BernardoPironio/Polarimetro/Informe/temp/Informe.pdf

Construcción de un polarímetro óptico dinámico

Grupo 13

Barros Martina, Pironio Bernardo

barrosmartina.bm@gmail.com, bpironio@gmail.com

Laboratorio de iones y atomos frios, 1

er cuatrimestre 2026
Departamento de Física, FCEyN, UBA

20 de julio de 2026

Resumen

Se presenta el diseño y construcción de un polarímetro óptico dinámico destinado a la caracterización del estado de polarización de un haz de luz mediante la reconstrucción de sus parámetros de Stokes. El sistema óptico está compuesto por una lámina de cuarto de onda en rotación continua y un polarizador lineal, mientras que la intensidad transmitida se registra mediante un fotodiodo. La rotación de la lámina se implementa utilizando un motor brushless, cuya posición angular se sincroniza mediante un sensor magnético. El sistema electrónico incorpora un circuito el cual posee un potenciómetro digital que permite optimizar la adquisición evitando la saturación del detector. Asimismo, se desarrolla un software de adquisición y análisis capaz de registrar los datos en tiempo real, realizar la calibración del instrumento y reconstruir el estado de polarización del haz incidente. Si bien la implementación final del polarímetro no se completa durante este trabajo, se verifica el correcto funcionamiento de cada uno de los subsistemas desarrollados, aunque a aún son necesarias revisiones y ajustes en la calibración y en el montaje óptico para alcanzar una integración completa del sistema.

### 1. Introducción

En la física, particularmente la óptica cuántica, el estado de polarización de la luz es un recurso fundamental. Para poder medir y tener control sobre la polarización es útil contar con un polarímetro dinámico. Este instrumento permite medir el estado de polarización de la luz en tiempo real y de forma automatizada.
Existen extensos ejemplos de la utilidad de contar con un polarímetro, uno de estos es la codificación de información en la polarización de los fotones, ya que es un grado de libertad del cual se tiene un control robusto. Otro ejemplo aparece en la medición de resonancias oscuras de los iones, donde un estado de polarización inestable provoca que los valles de la señal de fluorescencia no sean tan distinguibles como se requiere para la medición de resonancia [1].
Una de las formas de describir el estado de polarización de la luz es a partir de los parámetros de Stokes [2]. Estos cuatro parámetros S0, S1, S2 y S3 nos indican la intensidad de la luz, la diferencia de intensidades entre luz polarizada horizontal y vertical, la diferencia de intensidades entre luz polarizada a 45◦ y −45◦ y la diferencia de intensidades entre luz polarizada circularmente a derecha e izquierda, respectivamente. Estos parámetros luego definen al vector de Stokes,

S⃗ =

s1
s2
s3
- ,

donde si = Si/S0. Este vector permite representar el estado de polarización de la luz en la esfera de Poincaré, tal que los polos representan la polarización circular y el ecuador representa la polarización lineal. Además, es posible definir el grado de polarización como,

DOP =

q
s

2
1 + s

2
2 + s

2/3.

Entre las múltiples posibilidades para la construcción del polarímetro [3], un diseño común consiste en una lámina de onda seguida de un polarizador lineal. Para describir matemáticamente estos elementos ópticos, y por lo tanto el sistema, se utilizan las matrices de Müller.
Si se considera una polarización incidente descrita por S⃗
in y las matrices de Müller de una lámina con retardo δ (rotada un ángulo θ) y un polarizador lineal (asumiendo que el eje de transmisión del polarizador está alineado con el eje horizontal con respecto a la mesa óptica) se obtiene la polarización de salida a partir de la siguiente ecuación,

S⃗

out = MLP · MR(θ, δ) · S⃗
in,

con la cual se calcula la intensidad de salida, llegando a la expresión,

I(θ) = a0 + a2 sin 2θ + a4c cos 4θ + a4s sin 4θ (1)

con,

a0 =

S0
2

+

S1
4

(1 + cos δ),

a2 = −

S3
2

sin δ,

a4c =

S1
4

(1 − cos δ),

a4c =

S2
4

(1 − cos δ).

La cuenta para llegar a dicha expresión y las matrices de Müller se explican con detalle en el apéndice A.

El objetivo de este informe es describir el diseño e implementación de un polarímetro dinámico.

### 2. Armado del polarímetro

Para la construcción del polarímetro se opta por un sistema óptico compuesto por una lámina de cuarto de onda rotante, un polarizador lineal y un fotodiodo encargado de medir la intensidad de la señal de salida. La rotación de la lámina permite modular la polarización incidente, de modo que la intensidad detectada varía con el ángulo de giro según la ecuación 1, lo que posibilita la determinación de los parámetros de Stokes para cualquier polarización.

La lámina de cuarto de onda se monta sobre un motor sin escobillas (BLDC) que permite rotarla manteniendo una velocidad constante y presenta bajas vibraciones, manteniendo un movimiento suave, necesario para garantizar que la modulación de la señal sea uniforme. La señal de salida del fotodiodo se adquiere mediante un microcontrolador que también se encarga de controlar la velocidad del motor y enviar los datos a una computadora para su posterior análisis. Se utiliza una carcasa impresa en 3D para montar la lámina al motor. A esta se le encastra un imán en el exterior que, junto con un encoder magnético, detecta el número de vueltas del motor; esta información es necesaria para asignar las distintas mediciones de voltaje al ángulo de rotación de la lámina. En la Figura 1 se observa un diagrama del dispositivo descrito.

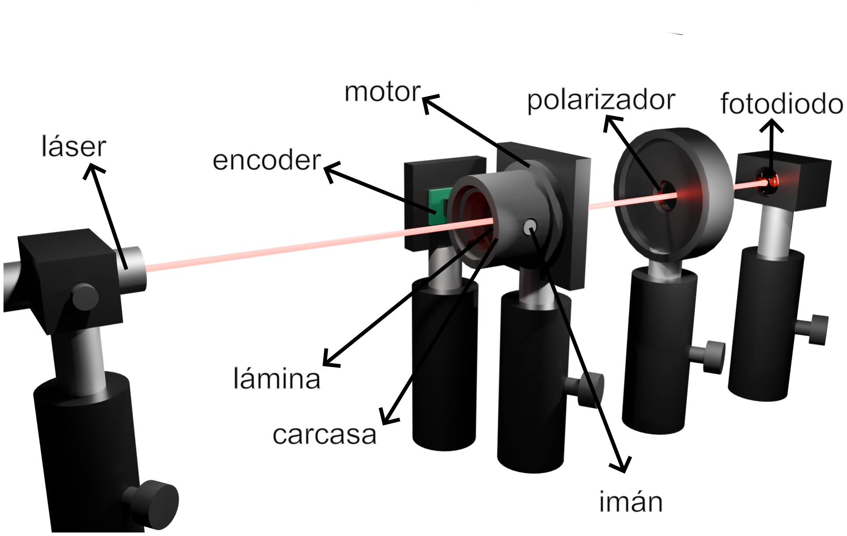
[picture p1: figure]
láser; encoder; imán; polarizador; fotodiodo otor; carcasa; lámina

Figura 1: Diagrama del montaje del polarímetro. Se observa el montaje óptico que incluye el láser de referencia, la carcasa que contiene a la lámina y el imán encastrado, el encoder magnético, el polarizador lineal y el fotodiodo.

### 2.1. Sistema óptico

Para la construcción del polarímetro se utiliza como referencia un láser de 630-660 nm, con una potencia menor a 5 mW. Se utiliza una lámina de cuarto de onda
B. Halle para 633 nm y un polarizador lineal del mismo fabricante. Para la medición de la intensidad de salida se utiliza un fotodiodo de silicio [4]. Para la alimentación del fotodiodo se monta un circuito, inicialmente alimentado con una fuente externa, compuesto por un regulador de voltaje LM1117 [5] de 3.3 V y un amplificador operacional LM324N [6] para convertir la corriente del fotodiodo en un voltaje proporcional a la intensidad de luz incidente.
El circuito también incluye un potenciómetro digital
[7] para ajustar la ganancia del amplificador y así maximizar el voltaje medido sin permitir que la señal sature. El potenciómetro contiene internamente 100 pasos de resistencias desde los 40 Ω hasta 10 kΩ que se recorren utilizando un microcontrolador. El circuito completo se muestra en la Figura 7 del apéndice B.
La señal de salida del fotodiodo se adquiere mediante un microcontrolador Raspberry Pi Pico 2W [8], que se encarga de enviar los datos a una computadora y regular el valor del potenciómetro digital de forma automática. Esta regulación se logra comparando los valores vecinos de una medición y pidiendo que la diferencia entre estos tome un valor que no sea despreciable, si esto no se cumple, se aumenta el valor de la resistencia; repitiendo el proceso hasta evitar la saturación de la señal.

### 2.2. Control del motor

La lámina se monta sobre un motor BLDC 2204-260KV con eje hueco, controlado por la Raspberry Pi Pico. Este motor no utiliza escobillas, sino que la conmutación de las fases es eléctrica. Además, el rotor está formado por imanes permanentes y el estator por bobinas con un arreglo de tres fases diferentes. Gracias a esto, el motor es capaz de girar más rápido y con mayor suavidad que otro tipo de motores, volviéndolo más eficiente que otros. En la Figura 2 se observa un esquema del motor.

Rotor externo

Estator

Fases

Imanes permanentes

Figura 2: Se observa un esquema del motor visto desde frente. Este posee el rotor con imanes permanentes cuyos colores (azul y rojo) representan la alternación en la polaridad de cada imán. En el centro se ubica el estator que contiene a las bobinas con las tres fases, representadas en rojo, verde y amarillo claro. Finalmente, se nota que el centro del motor es hueco.

Para controlar la velocidad del motor se evaluaron distintos drivers que traían diversas complicaciones; en particular, el SimpleFoc Mini [9] funcionaba correctamente solo mediante el uso de su librería lo cual requería trabajar a la par de un encoder centrado en el motor y esto impediría el paso del haz del láser.
Finalmente, se opta por utilizar el driver Brushless 3 Click [10]. Como se menciona anteriormente, la lámina se monta sobre el motor utilizando una carcasa impresa en 3D, que permite alinear el eje de rotación del motor con el eje óptico de la lámina. El encoder no se utiliza para medir la rotación del motor directamente, ya que para lograr esto es necesario que el imán esté perfectamente alineado con el centro del motor y hacer esto bloquearía el eje por donde pasa el haz de luz.

### 2.3. Implementación del dispositivo experi-

mental

Se implementa cada parte del dispositivo experimental mencionada anteriormente por separado. Se logra girar el motor con la lámina y controlar su velocidad, medir la señal con el fotodiodo (ajustando la ganancia automáticamente) y analizar los datos en tiempo real, visualizando el vector en la esfera de Poincaré. Al momento de realizar las mediciones finales no se consigue implementar todo el sistema simultáneamente, por lo que las mediciones de los siguientes análisis se realizan utilizando un motor paso a paso, que aporta una mayor facilidad al momento de controlarlo.
Además, para los siguientes análisis se coloca un polarizador lineal a la salida del láser, seguido de una lámina de media onda montada de forma que pueda rotarse manualmente. Este montaje no forma parte del polarímetro, sino que se emplea durante la etapa de calibración para generar estados de polarización lineal conocidos mediante la rotación del eje principal de la lámina de media onda, permitiendo validar la metodología de medición implementada.

### 3. Análisis de resultados: Vectores de Poincairé

Idealmente, la lámina de cuarto de onda introduce un retardo constante de δ = π/2 independientemente de la rotación de esta. Sin embargo, al ajustar las curvas de intensidad de las mediciones obtenidas, se observa que fijando el retardo a dicho valor, el ajuste no parece adecuarse a las mediciones.
Por otro lado, no definir el valor de δ, introduce una degeneración en el ajuste, ya que distintos valores del retardo pueden describir los datos experimentales. Consecuentemente, con el fin de reducir esa degeneración, se opta por parametrizar el retardo según el cuadrante de la lámina. Este modelo consiste en una función partida, definiendo el retardo δ de manera seccional como,

δ(ϕ) =

δ1, 0 ≤ ϕ < π
2
δ2,

π
2 ≤ ϕ < π

δ3, π ≤ ϕ < 3π
2
δ4,

3π
2 ≤ ϕ < 2π
El objetivo de las siguientes secciones es estudiar la repetibilidad de las mediciones, corroborando que los vectores no se distribuyan de manera aleatoria para la misma polarización, realizar una calibración de los parámetros δ de cada cuadrante y analizar las mediciones para múltiples polarizaciones lineales.

### 3.1. Análisis de múltiples curvas

Como un primer análisis, se estudia el comportamiento de las curvas de intensidad obtenidas para dos estados de polarización del haz incidente, correspondientes a rotaciones de 0

- y 45◦ de la lámina de media onda. Para cada configuración se ajustaron múltiples curvas de intensidad obtenidas en vueltas consecutivas de la lámina de cuarto de onda y, a partir de los parámetros ajustados, se calcularon los correspondientes vectores de Poincaré. Para cada caso, se realizó una calibración inicial y se fijaron los mismos valores de δ para todos los ajustes, con el fin de reducir el posible sobreajuste que podría surgir al ajustar cada curva de manera independiente. En la Figura 3 se observa la distribución de vectores obtenidos de cada medición y el vector promedio, estimado por la media de los vectores individuales.

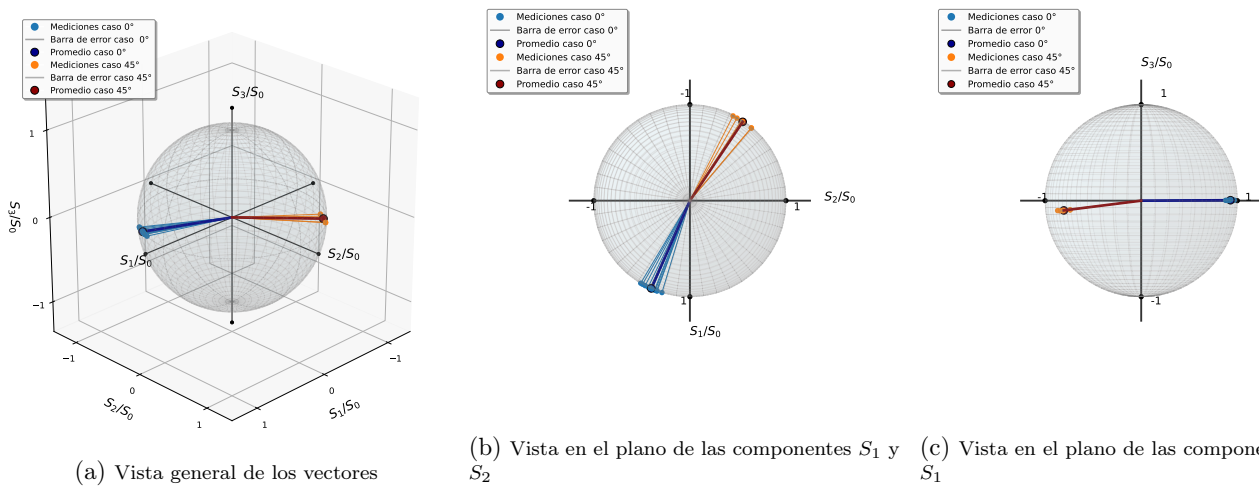
[picture p2: figure]
Mediciones caso 0° Barra de error caso 0° Promedio caso 0° Mediciones caso 45° Barra de error caso 45° Promedio caso 45°; (a) Vista general de los vectores; Mediciones caso 0° Barra de error 0° Promedio caso 0° Mediciones caso 45° Barra de error caso 45° Promedio caso 45°

(b) Vista en el plano de las componentes S1 y

S1/S0

S3/S0

(c) Vista en el plano de las componentes S3 y

Figura 3: Se disponen diferentes visualizaciones de los vectores de Poincaré obtenidos para la polarización lineal correspondida a una inclinación de 0° y 45° de la lámina de media onda. Las figuras (a), (b) y (c) muestran distintas perspectivas de las mismas mediciones para facilitar la visualización.

Este previo análisis es necesario para evaluar la repetibilidad de las mediciones y determinar su dispersión para un mismo estado de polarización. En este caso, para ambas configuraciones, no se evidencia una distribución aleatoria de los vectores sobre la esfera de Poincaré. Sin embargo, se observa una dispersión apreciable entre los vectores obtenidos, cuya magnitud tiene que considerarse para futuros análisis.
Con el fin de cuantificar la dispersión observada, se define un ángulo de incertidumbre ∆α, calculado a partir de la distribución de los vectores proyectados en el plano S1–S2. Se calcula como ∆α = |αmax −αmin|, donde αi = arctan
S2,i

S1,i
, siendo S1,i y S2,i los parámetros de Stokes ajustados para la medición i.
Para la configuración de una rotación de 0° de la lámina de media onda, se obtiene un valor de ∆α0 = (13.9◦±0.4◦
) y para la configuración de una rotación de 45°, el valor es de ∆α45 = (13.3◦±0.7◦
). Estos valores
pueden deberse a un error sistemático en la calibración realizada o las fluctuaciones experimentales del sistema.

### 3.2. Calibración de retardos

Dado que la libertad en los parámetros δ sigue permitiendo cierta degeneración, es decir, la existencia de múltiples valores que ajusten al modelo, se opta por determinarlos a partir del ajuste simultáneo de dos estados de polarización lineal ortogonales, obtenidos al orientar la lámina de media onda a 0

- y 45◦

Estas configuraciones generan dos polarizaciones lineales ortogonales, que en el sistema experimental se pueden identificar como polarización horizontal, para 0

◦
y vertical para 45◦
. En la esfera de Poincaré, rotar la lámina de media onda 45◦
se corresponde con que el
vector en la esfera rote 180◦
. Utilizar estas dos curvas para realizar la calibración, permite delimitar los retardos δi contemplando dos formas funcionales distintas de la intensidad medida.
Se eligen estas dos configuraciones, ya que, como se ve en la Figura 4, la forma funcional de ambas difiere tanto en la fase como en la modulación de los máximos, y para la calibración se requiere obtener valores para los δ que tengan en cuenta esta distinción.
Se ajustan los valores de intensidad I(t) registrados por el fotodiodo y el ángulo de rotación de la lámina de cuarto de onda (θ) para una vuelta completa, donde se define θ = θ0 + ωt, fijando θ0 = 0. Cabe aclarar, que también es posible calibrar θ0 tal que ciertos estados de polarización queden alineados con los ejes de la esfera de Poincaré.
El ajuste involucra doce parámetros libres: los cuatro parámetros de Stokes correspondientes a cada una de las dos curvas y los cuatro valores de retardo δi

. Con el fin de
eliminar la indeterminación asociada a una fase global, se fijó uno de los retrasos en δ1=1.57.
A partir de esto, en la Figura 4, se visualiza el ajuste realizado.

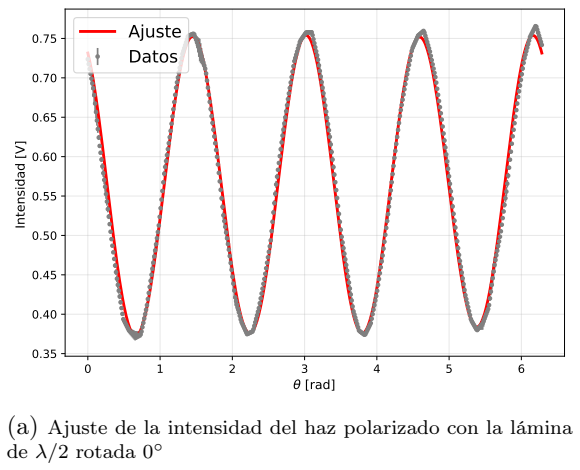
[picture p3: figure]
[rad]; Intensidad [V]; Ajuste Datos; de λ/2 rotada 0

(a) Ajuste de la intensidad del haz polarizado con la lámina

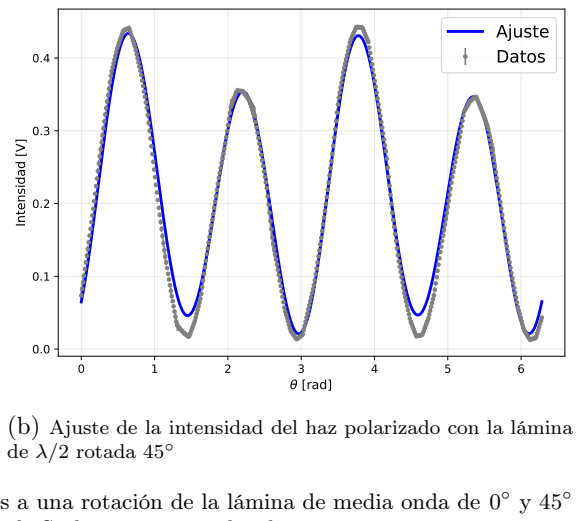
[picture p4: figure]
[rad]; Intensidad [V]; Ajuste Datos; de λ/2 rotada 45◦

(b) Ajuste de la intensidad del haz polarizado con la lámina

Figura 4: Se observa el ajuste realizado para las dos curvas, correspondientes a una rotación de la lámina de media onda de 0 respectivamente. Para ambos casos, el valor del DOP obtenido para el vector de Stokes toma un valor de 1.

Se delimitan los valores de los retardos a un intervalo de
[1.5, 1.65] rad y se descartan las soluciones sin sentido
físico, las curvas que correspondían a un vector de Poincaré con una norma mayor a 1 (DOP ≥ 1). Se obtienen los resultados de la Tabla 1.
δ | Valor (V) Incerteza (rad)
δ1 | 1.57 | 0
δ2 | 1.521 | 0.015
δ3 | 1.577 | 0.008
δ4 | 1.489 | 0.015

Tabla 1: Valores medidos para cada δ con su respectivo error. Se distingue que los valores se adecuan al valor esperado para la lámina de cuarto de onda, siendo que el más lejano no supera una diferencia de 0.08.

Las calibraciones de los parámetros δ se adecuan al valor esperado para la lámina de cuarto de onda (≈ 1.57) rad. Sin embargo, el valor que más difiere presenta una desviación de 0.08 rad, correspondiente a aproximadamente el 5 % del valor esperado.
Los parámetros de Stokes obtenidos para ambas configuraciones tienden a una polarización del tipo lineal, con una componente S3 no es nula pero considerablemente menor. En particular, para la polarización horizontal se obtiene S3H = (0.0018± 0.0019) V, mientras que para la polarización vertical se obtiene S3V = (−0.0811± 0.0018) V. Si bien idealmente debería anularse, estos resultados se pueden atribuir a imperfecciones en la preparación de la polarización lineal incidente o a la no linealidad de los elementos empleados. También puede deberse a desalineaciones de los elementos ópticos en el montaje experimental.
En la Figura 5 se observa una representación de ambos vectores desde diferentes perspectivas. Dado que son dos polarizaciones que se diferencian en una rotación de 90◦
, se espera que se encuentren en extremos opuestos de la esfera y por ser polarizaciones lineales, se espera también que se encuentren contenidos en el plano S1 y S2.

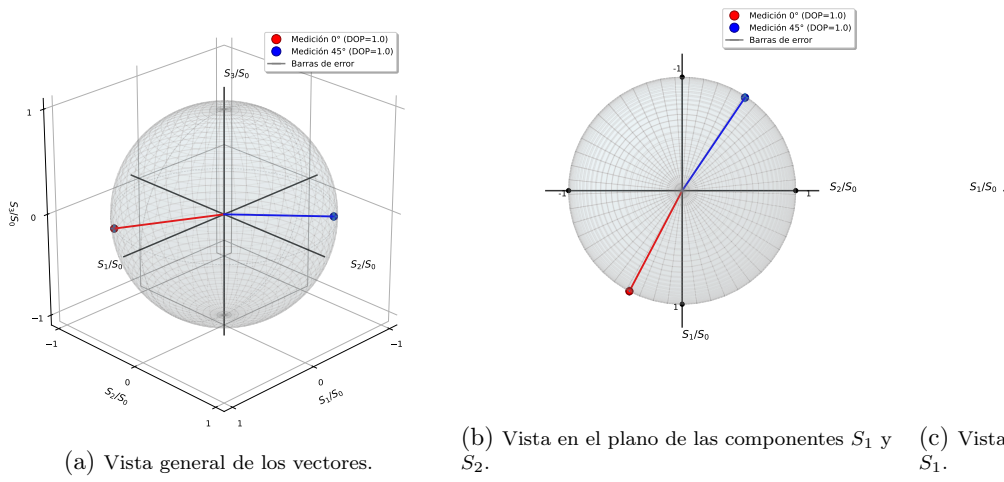
[picture p5: figure]
Medición 0° (DOP=1.0) Medición 45° (DOP=1.0) Barras de error; (a) Vista general de los vectores.

(b) Vista en el plano de las componentes S1 y

S3/S0

Medición 0° (DOP=1.0)
Medición 45° (DOP=1.0)
Barras de error
1 | -1

-1

(c) Vista en el plano de las componentes S3 y

Figura 5: Se disponen diferentes visualizaciones de los vectores de Poincaré obtenidos para la polarización lineal correspondida a una inclinación de 0° y 45. Las Figuras (a), (b), y (c) representan distintas perspectivas de la misma medición para facilitar la visualización.

En la Figura 5c se aprecia nuevamente la presencia de
la componente S3. Sin embargo, al proyectar los vectores
sobre el plano S1 − S2 (Figura 5b) se observa que ambos ocupan posiciones aproximadamente opuestas sobre la esfera de Poincaré. Para cuantificar este comportamiento se calculó el producto escalar entre los vectores de Stokes normalizados correspondientes a ambas polarizaciones, obteniéndose ⃗sH. ⃗sV = −0.9937 ± 0.0005, para tener una referencia numérica de cuan opuestos son. Este resultado es próximo al valor ideal de −1, correspondiente a dos estados de polarización ortogonales representados por vectores antipodales sobre la esfera de Poincaré. De forma equivalente, el ángulo entre ambos vectores resulta α =173.6◦ ± 0.2◦

Si bien este resultado se aproxima al valor esperado de 180◦

, se observa una desviación de 6.4◦
, un 4 % del valor ideal. Esto indica que los estados obtenidos presentan una discrepancia respecto a la ortogonalidad ideal.

Estos resultados pueden ser consecuencia de que la lámina de media onda no esté introduciendo exactamente un retardo de π/2 para la longitud de onda del láser. Se puede estudiar este efecto manteniendo fija la lámina y variando el ángulo del polarizador del láser.
Otra posible hipótesis es que la calibración empleada no determina adecuadamente los parámetros del sistema y por ende, se observa discrepancias con los valores esperados.

### 3.3. Barrido de polarizaciones

Luego de haber calibrado la lámina de cuarto de onda, se procede a caracterizar la respuesta ante diferentes estados de polarización del láser. Es decir, obtener los vectores de Poincaré para diferentes ángulos de rotación de la lámina de media onda que equivale a rotar el ángulo del eje de la polarización lineal.
Teniendo la calibración previamente realizada, se ajusta la curva de una vuelta de cada configuración fijando los cuatro retardos. En la Figura 6 se observa una representación de cada uno de los vectores desde diferentes perspectivas.

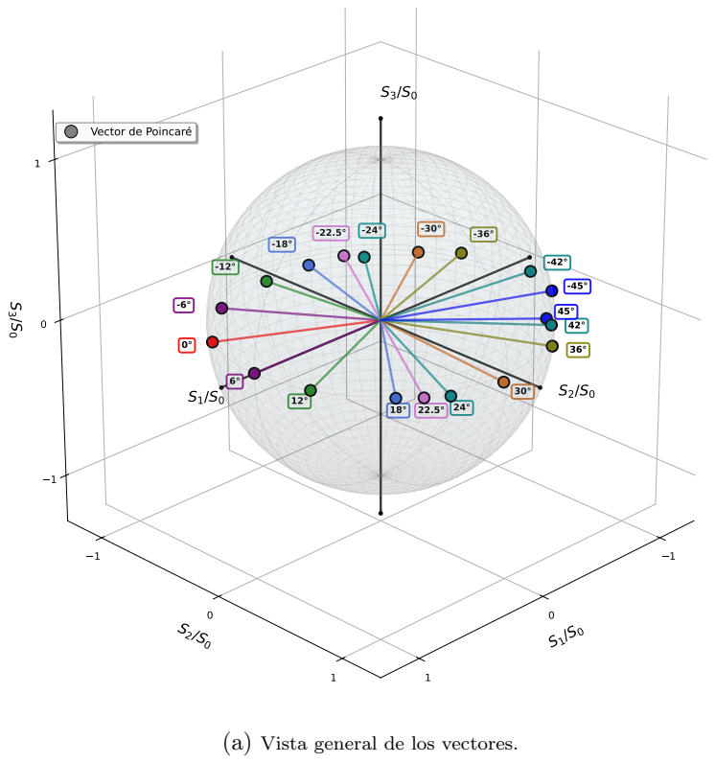
[picture p6: figure]
Vector de Poincaré; -42° -45° (a) Vista general de los vectores.
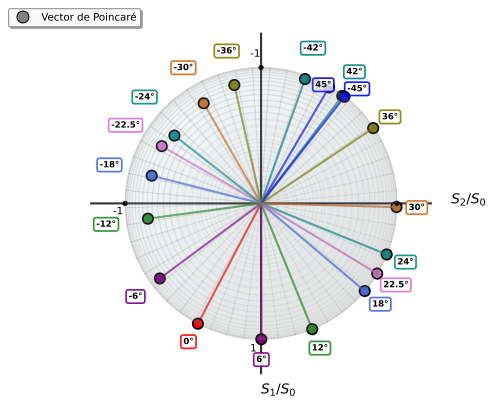
[picture p7: figure]
Vector de Poincaré

(b) Vista en el plano de las componentes S1 y S2.

S1/S0

S3/S0 Vector de Poincaré

1 | -1

1

-1

36°
45° 42°

-36°

-42° -45°

(c) Vista en el plano de las componentes S3 y S1.

Figura 6: Se disponen diferentes visualizaciones de los vectores de Poincaré obtenidos para distintas polarizaciones lineales. Las referencias de ángulos corresponden a la rotación de la lámina de media onda. Las Figuras (a), (b) y (c) representan distintas perspectivas de la misma medición para facilitar la visualización.

Siguiendo el modelo teórico, los vectores deben ubicarse sobre la superficie de la esfera (DOP = 1), dado que el haz se polarizó completamente con un polarizador lineal y la rotación de la lámina solo afecta la orientación de la polarización. Sin embargo, la Figura 6b muestra que hay algunos casos en los cuales no sucede (ver Apéndice C). El valor más alejado del grado de polarización esperado toma un valor de 0.81 para el caso en el que la lámina se rota −24◦
. Esto indica que los vectores de dichas polarizaciones se encuentran dentro de la esfera, lo cual correspondería a que poseen una polarización parcial. En principio, una falta de precisión en la determinación de los δ afecta a la definición de los parámetros de Stokes y por ende el vector de la esfera de Poincaré. En segundo lugar, si la lámina de media onda no es ideal, el grado de polarización también podría verse afectado. Además, en la Figura 6c se observa la presencia de la componente S3, como sucedió en el análisis de la calibración. Aunque, los vectores están contenidos en mayor proporción en el plano S1 y S2 siguen habiendo resultados de algunas polarizaciones que indican que presentan componente circular o elíptica en su polarización.
A partir de estos resultados, por un lado, se evidencia una tendencia compatible con la generación de polarizaciones lineales a partir de la rotación de una lámina de media onda, dado que se observa una trayectoria donde los vectores tienden a recorrer el ecuador de la esfera de Poincaré. Por otro lado, las discrepancias observadas en el grado de polarización DOP y la presencia de la componente S3 indican que el sistema requiere ajustes en los elementos ópticos o bien en la calibración empleada.

### 4. Conclusiones

En este trabajo se diseña, construye y caracteriza un polarímetro óptico dinámico. Para ello es necesario desarrollar e integrar distintos subsistemas (óptico, mecánico y electrónico), incluyendo el control de velocidad del motor, la adquisición de la señal mediante el fotodiodo y la transmisión de datos a una computadora para su análisis

en tiempo real.
Si bien se implementan y validan los diferentes subsistemas del dispositivo, la configuración utilizada para las mediciones finales no corresponde al sistema definitivo. En particular, el control del motor BLDC no se integra completamente en la etapa final del experimento, por lo que las mediciones de caracterización se realizan utilizando un motor paso a paso.
En cuanto al análisis de las mediciones, se logra visualizar una distribución no aleatoria, aunque con una desviación apreciable, para dos polarizaciones distintas. La calibración realizada a partir de dos estados de polarización lineal, correspondientes a orientaciones de la lámina de media onda de 0
- y 45◦
, permite determinar
los retardos efectivos de cada cuadrante e incorporarlos al modelo de ajuste para otras configuraciones de polarización. A partir de esta calibración, los vectores de Poincaré obtenidos para un barrido de distintas polarizaciones lineales determinadas según la rotación de una lámina de media onda, parecen mostrar una trayectoria alrededor del ecuador de la esfera, asimilándose a la teoría esperada. No obstante, algunas configuraciones presentan una componente residual S3 y DOP’s cercanos a 0.8, lo que sugiere la presencia de desalineación del sistema experimental o de no linealidad de los elementos ópticos que afecten la polarización del haz. Otra de las hipótesis, es que el modelo de calibración aún requiere modificaciones.
Finalmente, los resultados obtenidos constituyen un paso importante en el desarrollo del proyecto; sin embargo, será necesario continuar perfeccionando la calibración y el montaje experimental para concretar la implementación íntegra del sistema.

### Referencias

[1] Nicolás A. Nuñez Barreto et al. «Dark resonance spectra of trapped ions under the influence of micromotion». En: Frontiers in Quantum Science and Technology 3 (2024), pág. 1381117. doi: 10 . 3389 / frqst . 2024 . 1381117. url: https://doi.org/10.3389/frqst.2024.1381117.
[2] Max Born y Emil Wolf. Principles of Optics: Electromagnetic Theory of Propagation, Interference and Diffraction of Light. 7.a ed. Cambridge: Cambridge University Press, 1999. isbn: 9780521642224.
[3] P. S. Hauge. «Recent Developments in Instrumentation in Ellipsometry». En: Surface Science 96 (1980), págs. 108-140. doi: 10.1016/0039-6028(80)90235-4. (https://doi.org/10.1016/0039-6028(80)90235-4)
[4] Vishay Siliconix. BPW24R Datasheet. https : / / www . alldatasheet . es / datasheet - pdf / pdf / 26250 / VISHAY/BPW24R.html. (https://www.alldatasheet.es/datasheet-pdf/pdf/26250/VISHAY/BPW24R.html) Accedido: 2024-06-10.
[5] Cystech Electronics Corp. LM1117-3.3 Datasheet. https://www.alldatasheet.com/datasheet-pdf/pdf/141837/CYSTEKEC/LM1117-3.3.html. (https://www.alldatasheet.com/datasheet-pdf/pdf/141837/CYSTEKEC/LM1117-3.3.html) Accedido: 2024-06-10.
[6] NXP Semiconductors. LM324N Datasheet. https://www.alldatasheet.com/datasheet-pdf/pdf/17880/PHILIPS/LM324N.html. (https://www.alldatasheet.com/datasheet-pdf/pdf/17880/PHILIPS/LM324N.html) Accedido: 2024-06-10.
[7] Renesas Technology Corp. X9C102P Datasheet. https://www.alldatasheet.com/view.jsp?Searchword=X9C102P. (https://www.alldatasheet.com/view.jsp?Searchword=X9C102P) Accedido: 2024-06-10.

[8] Raspberry Pi Foundation. Raspberry Pi Pico. https://www.raspberrypi.com/products/raspberry-pipico/. (https://www.raspberrypi.com/products/raspberry-pi-pico/) Accedido: 2024-06-10.
[9] SimpleFOCDocs. SimpleFOCMini v1.1. https://docs.simplefoc.com/simplefocmini. Accedido: 2024-06-13.
[10] MIKROE. Brushless 3 Click. https://www.mikroe.com/brushless-3-click?srsltid=AfmBOopd5Ca63SpGemQ6CAHFPnvUmYO77ESzQUOtvTsLpmTR3OSRujP. (https://www.mikroe.com/brushless-3-click) Accedido: 2024-06-10.

### 5. Declaración del uso de IA

En este trabajo utilizamos ChatGPT y Claude para: sugerencias de redacción y parafraseo durante todo el informe (solo para oraciones específicas), sugerencias de depuración del código y optimización del mismo. No se utilizaron herramientas de IA para generar datos, interpretar resultados ni elaborar las conclusiones. Todo el contenido técnico y experimental fue realizado y verificado por los y las estudiantes.

### A. Cálculo de la intensidad de salida

La siguiente ecuación detalla el cálculo de la intensidad de la luz de salida tras pasar por la lámina rotada y el polarizador lineal. En general, mencionamos que Sout = MLP ·MR(θ, δ)·Sin = MLP ·S

′
, donde estamos definiendo S

′ = MR(θ, δ) · Sin. Las matrices de Müller de una lámina de retardo δ (rotada un ángulo θ) y un polarizador lineal (asumiendo que el eje de transmisión está alineado con el eje horizontal) son,

MR(θ, δ) =

1 | 0 | 0 | 0
0 | cos² 2θ + sin²
2θ cos δ | sin 2θ cos 2θ(1 − cos δ) − sin 2θ sin δ
0 sin 2θ cos 2θ(1 − cos δ) | sin²
| | θ + cos² 2θ cos δ | cos 2θ sin δ
0 | sin 2θ sin δ | − cos 2θ sin δ | cos δ
,

MLP =

1
2

1 1 0 0
1 1 0 0
0 0 0 0
0 0 0 0

respectivamente.
Calculando S

′
con la matriz de Müller de la lámina se evidencia que,
(
S

′
0 = S0
S

′
1 = (cos² 2θ + cos δ sin²
2θ) · S1 + (1 − cos δ) sin 2θ cos 2θ · S2 − sin δ sin 2θS3

Finalmente, si calcula MLP · S

′
, se obtiene la siguiente expresión para la intensidad:

I(θ) = 1
2

(S

′
0 + S

′
1

) = S0
2

+

S1
2

(cos²

2θ + cos δ sen²

2θ) + S2
2

(1 − cos δ) sin 2θ cos 2θ −

S3
2

sin δ sin 2θ,

donde luego de utilizar ciertas identidades trigonométricas,

I(θ) = a0 + a2 sin 2θ + a4c cos 4θ + a4s sin 4θ | (2)

con,

a0 =

S0
2

+

S1
4

(1 + cos δ),

a2 = −

S3
2

sin δ,

a4c =

S1
4

(1 − cos δ),

a4c =

S2
4

(1 − cos δ).

### B. Circuito del fotodiodo

La figura muestra el circuito utilizado para alimentar el fotodiodo y convertir la corriente de salida en un voltaje proporcional a la intensidad de la luz. El circuito también cuenta con un potenciómetro digital para ajustar la

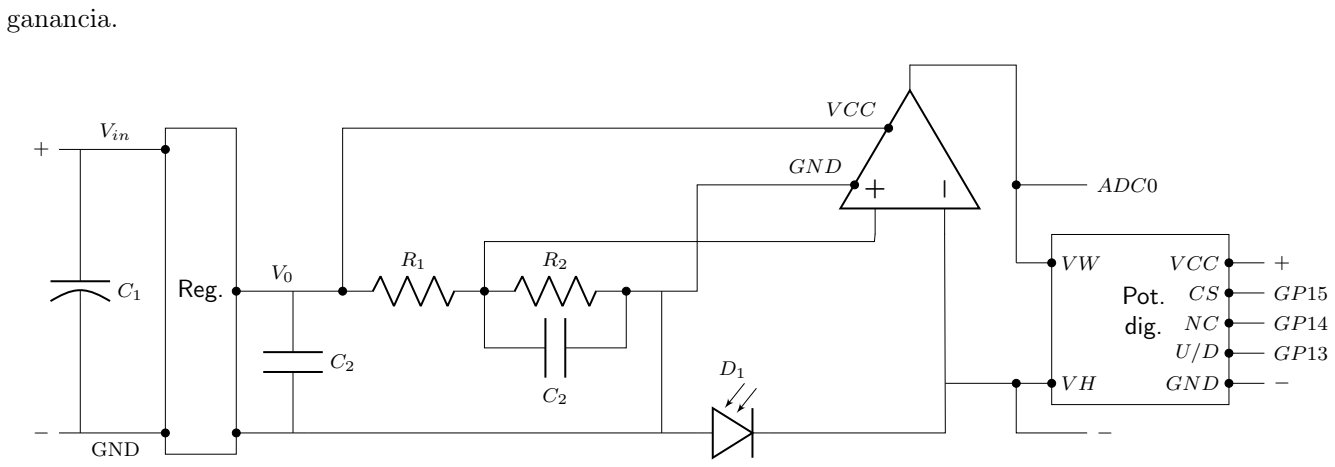
[picture p8: figure]
ganancia.; Vin; GND; Reg.; ADC0; Pot. dig.

Figura 7: Circuito utilizado para la alimentación del fotodiodo y ajuste de ganancia. Este se compone de un regulador de 3,3 V, un amplificador operacional, el fotodiodo y un potenciómetro digital. El capacitar C1 es electrolítico de 10 µF, los capacitores C2 son capacitroes cerámicos de 1 nF, ambos se utilizan como filtros. Las resistencias R1 y R2 toman valores de 10 kΩ y 220 Ω respectivamente. Las salidas CS, NC, U/D del potenciómetro digital controlan el guardado en memoria, el incremento del paso y la dirección de incremento respectivamente. Las conexiones ADC0, GP hacen referencia a las Raspberry Pi Pico.

### C. Valores de DOP para distintas polarizaciones

En la siguiente tabla se lee el valor que toma el DOP para cada polarización medida en la Figura 6.

Angulo Valor (DOP)
0
- 1.000± 0.004
6
- 1.000± 0.009
12◦ | 1.000± 0.012
18◦ | 1.000± 0.011
22,5
- 1.000± 0.017
24◦ | 1.000±0.016
30◦ | 1.000±0.013
36◦ | 1.000±0.06
42◦ | 1.000±0.05
45◦ | 1.000±0.04
−6
- 0.927±0.04
−12◦ | 0.840±0.05
−18◦ | 0.830±0.04
−22,5
- 0.843±0.04
−24◦ | 0.809±0.04
−30◦ | 0.849±0.02
−36◦ | 0.894±0.03
−42◦ | 0.973±0.04
−45◦ | 1.00±0.04

Tabla 2: Valores del DOP para distintas polarizaciones. El ángulo indica la rotación de la lámina de media onda con respecto a 0
◦
