BernardoPironio/Polarimetro/Informe/Figuras/allcomf_lat.png

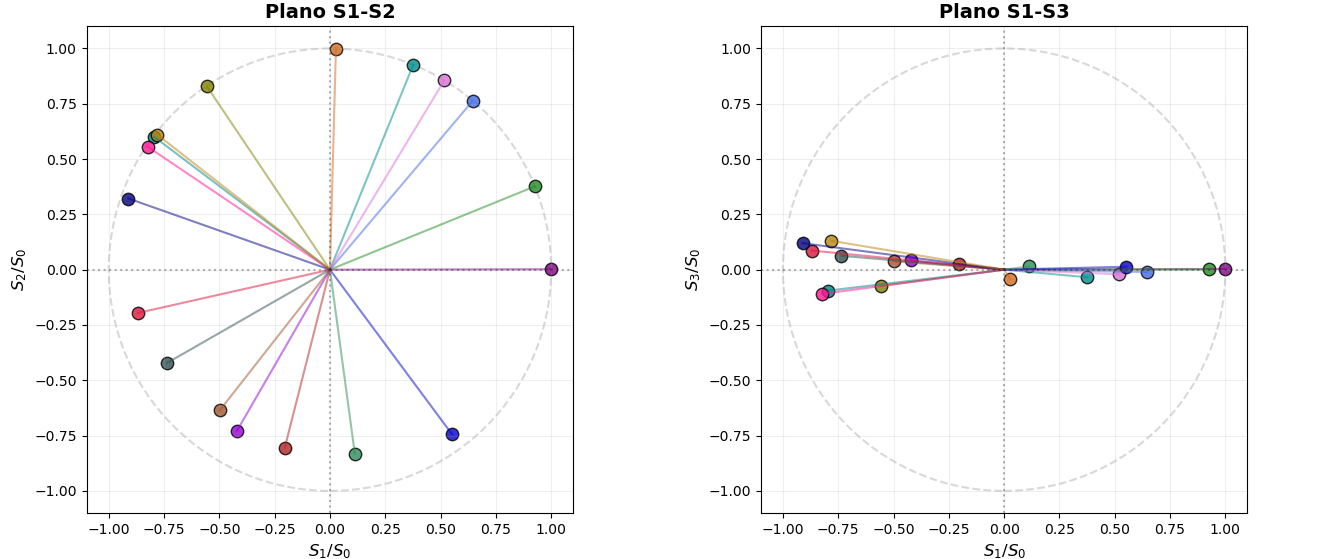
Informe/Figuras/allcomf_lat.png
