BernardoPironio/Polarimetro/Informe/Figuras/allcomf_lats2.png

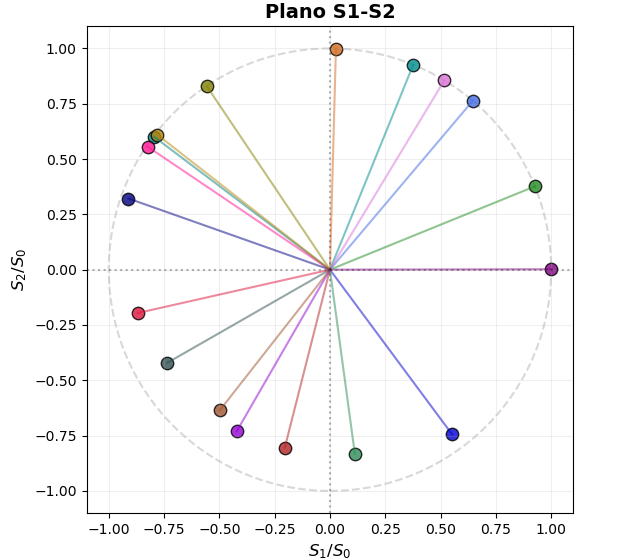
Informe/Figuras/allcomf_lats2.png
