BernardoPironio/Polarimetro/Informe/Figuras/allcomf_lats3.png

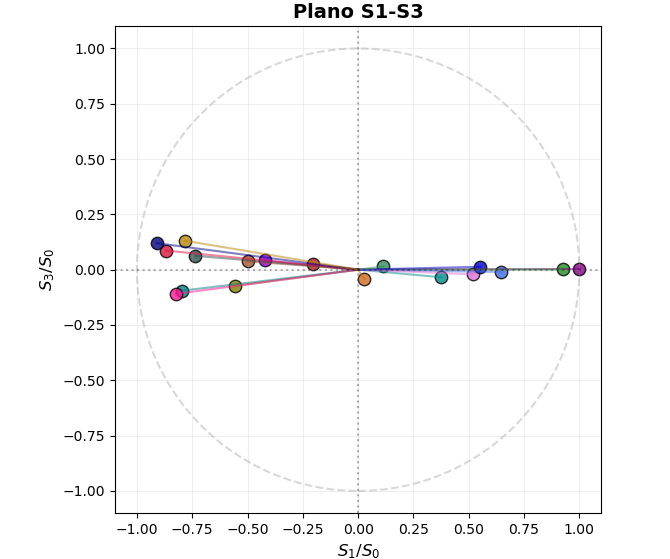
Informe/Figuras/allcomf_lats3.png
