BernardoPironio/Polarimetro/Informe/Figuras/cal_S2S1.png

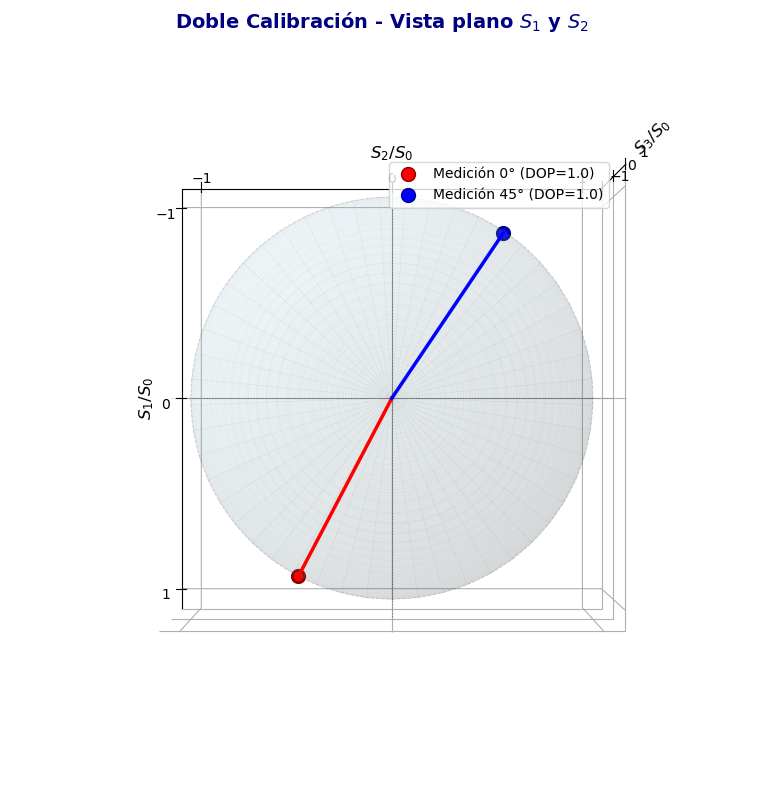
Informe/Figuras/cal_S2S1.png
