BernardoPironio/Polarimetro/Informe/Figuras/cal_S3S1.png

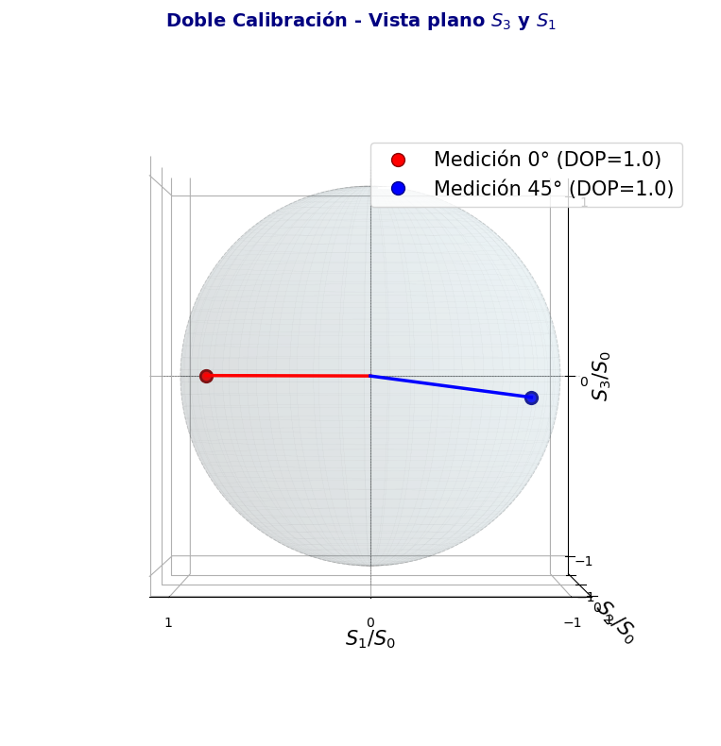
Informe/Figuras/cal_S3S1.png
