BernardoPironio/Polarimetro/Informe/Figuras/dobleaj.png

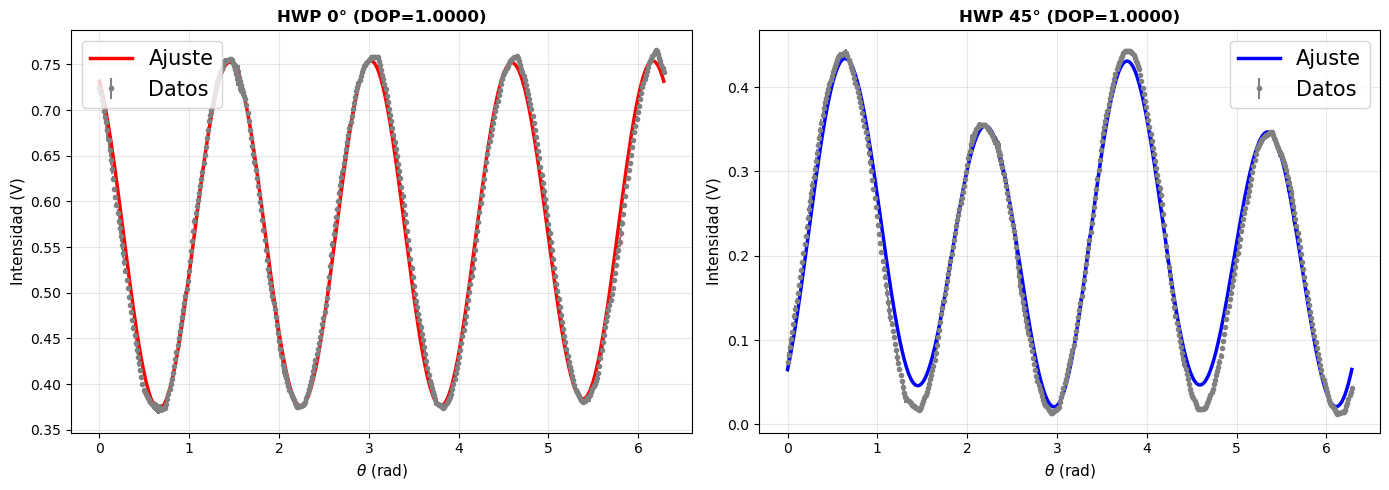
Informe/Figuras/dobleaj.png
