BernardoPironio/Polarimetro/Informe/Figuras/esferacal_vistagral.png

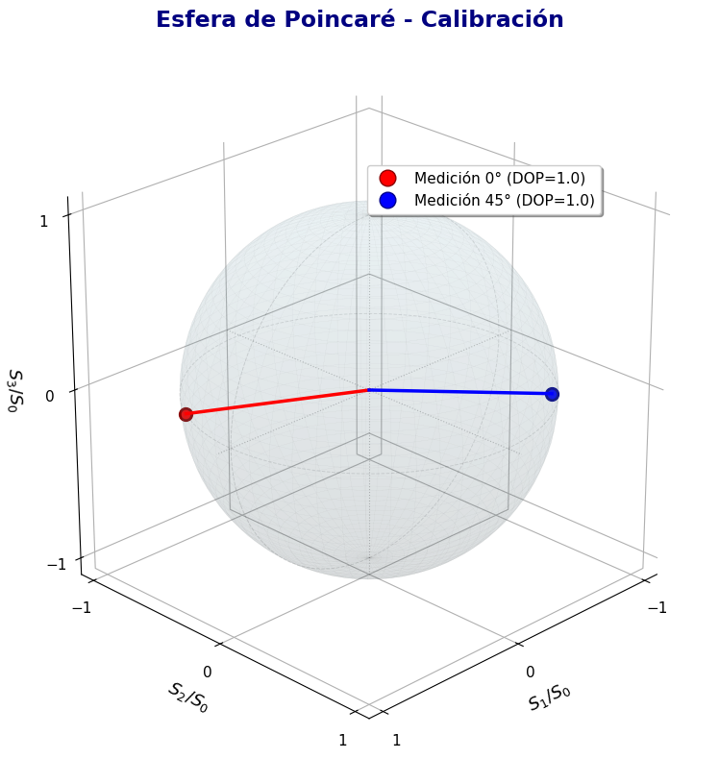
Informe/Figuras/esferacal_vistagral.png
