BernardoPironio/Polarimetro/Informe/Figuras/LateralS3S2.png

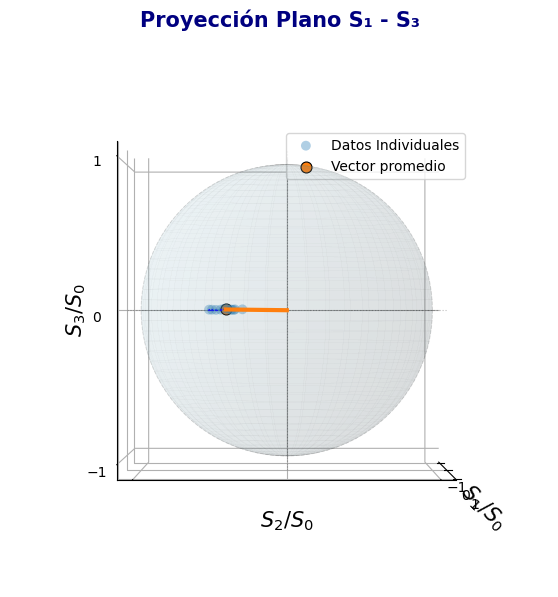
Informe/Figuras/LateralS3S2.png
