BernardoPironio/Polarimetro/Informe/Figuras/Render dispositivo.png

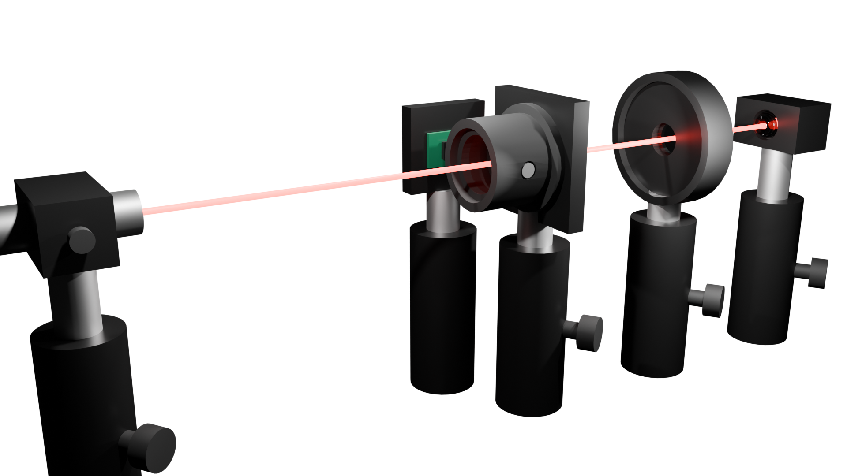
Informe/Figuras/Render dispositivo.png
