BernardoPironio/Polarimetro/Informe/Figuras/VistaGral.png

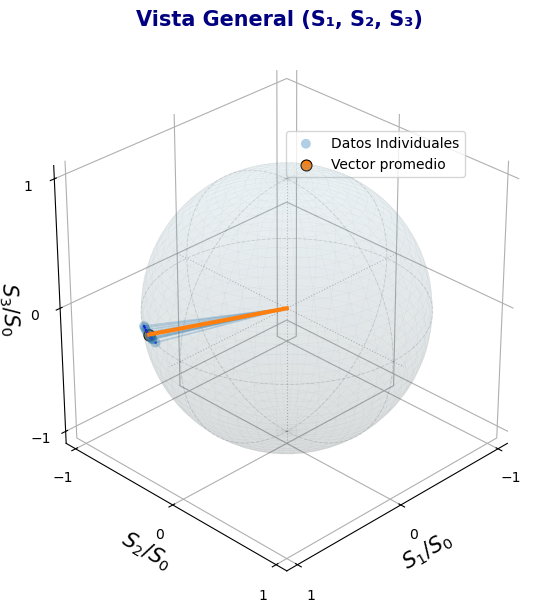
Informe/Figuras/VistaGral.png
