BernardoPironio/Polarimetro/Informe/Figuras/vistagral_allconfig.png

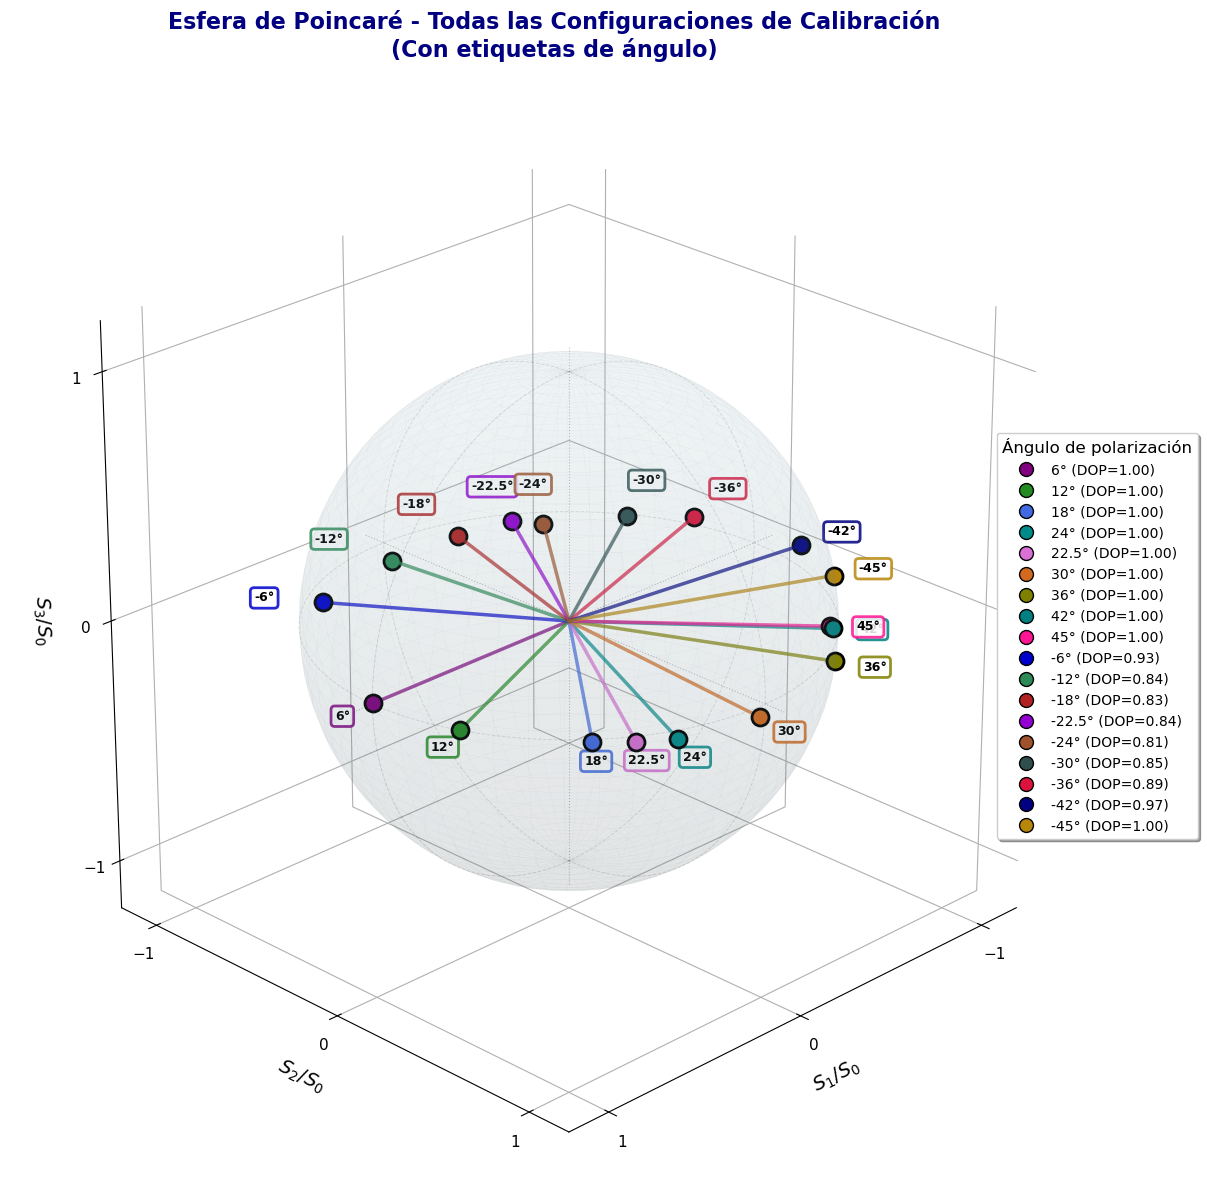
Informe/Figuras/vistagral_allconfig.png
