BernardoPironio/Polarimetro/Informe/Figuras/VistaplanoS1S2.png

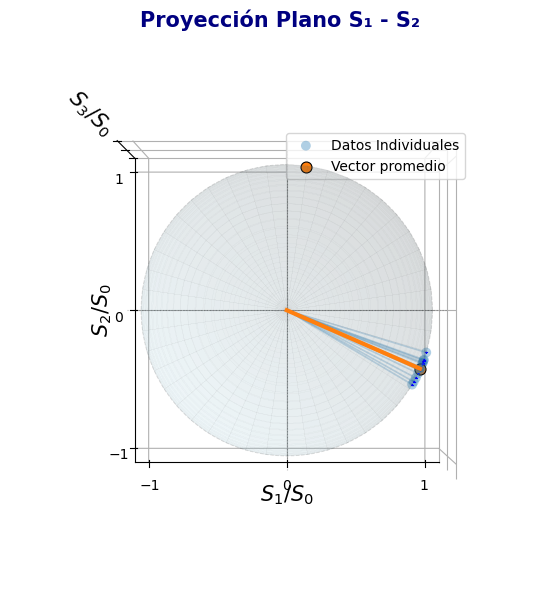
Informe/Figuras/VistaplanoS1S2.png
