BernardoPironio/Polarimetro/Informe/Figuras/vistaslaterales_allconfig.png

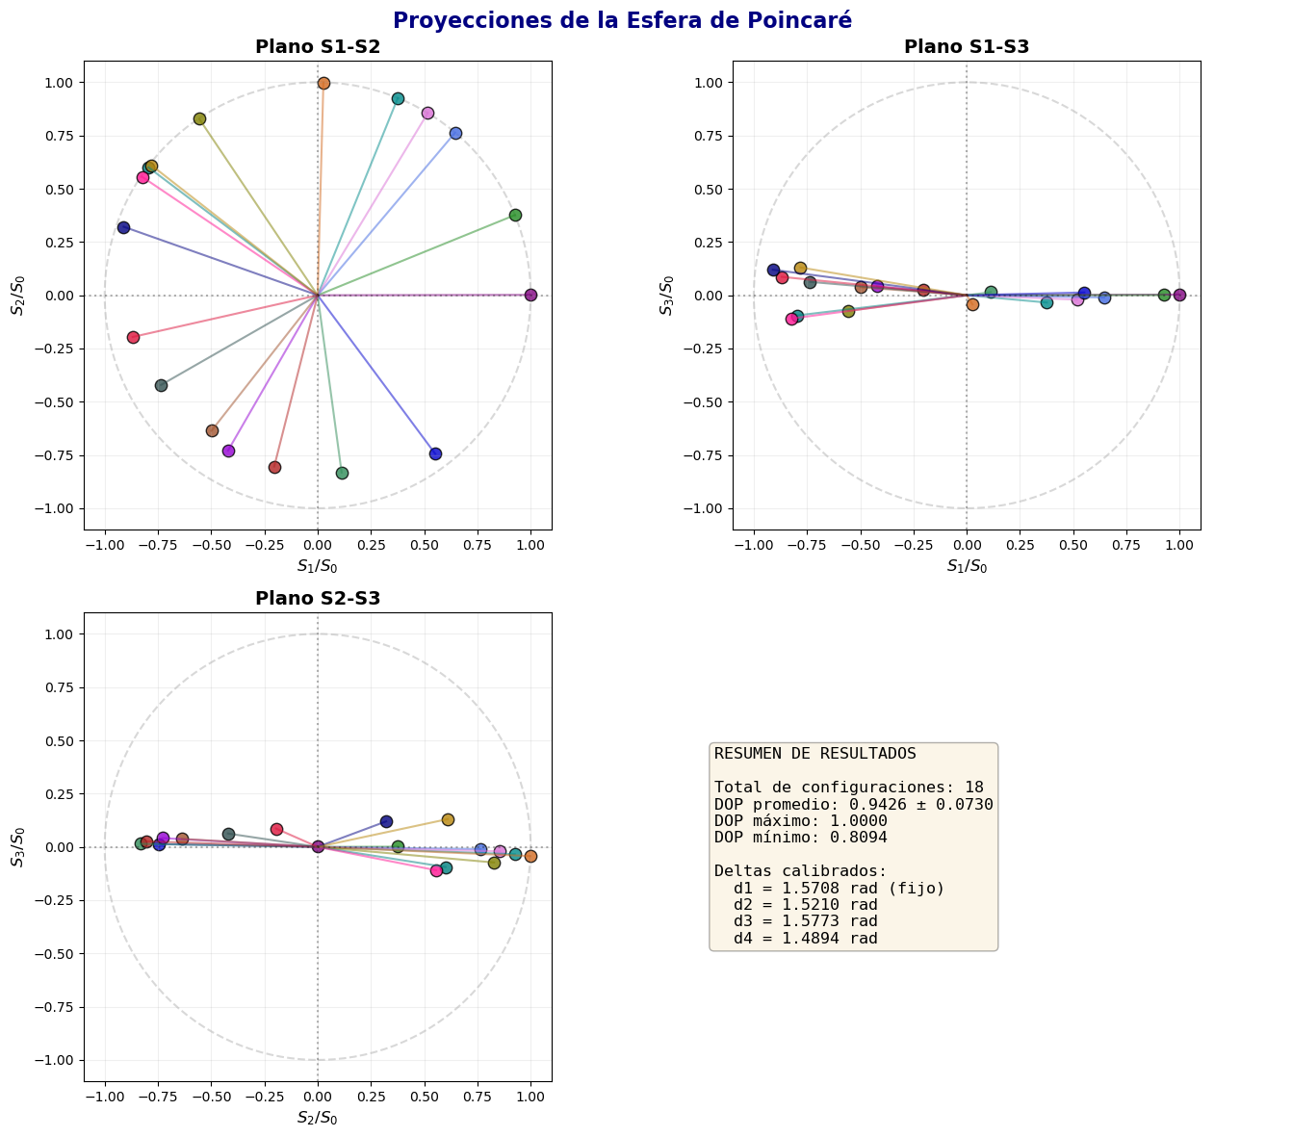
Informe/Figuras/vistaslaterales_allconfig.png
