BernardoPironio/Polarimetro/Pico Code/Clases/proyecciones_poincare.png

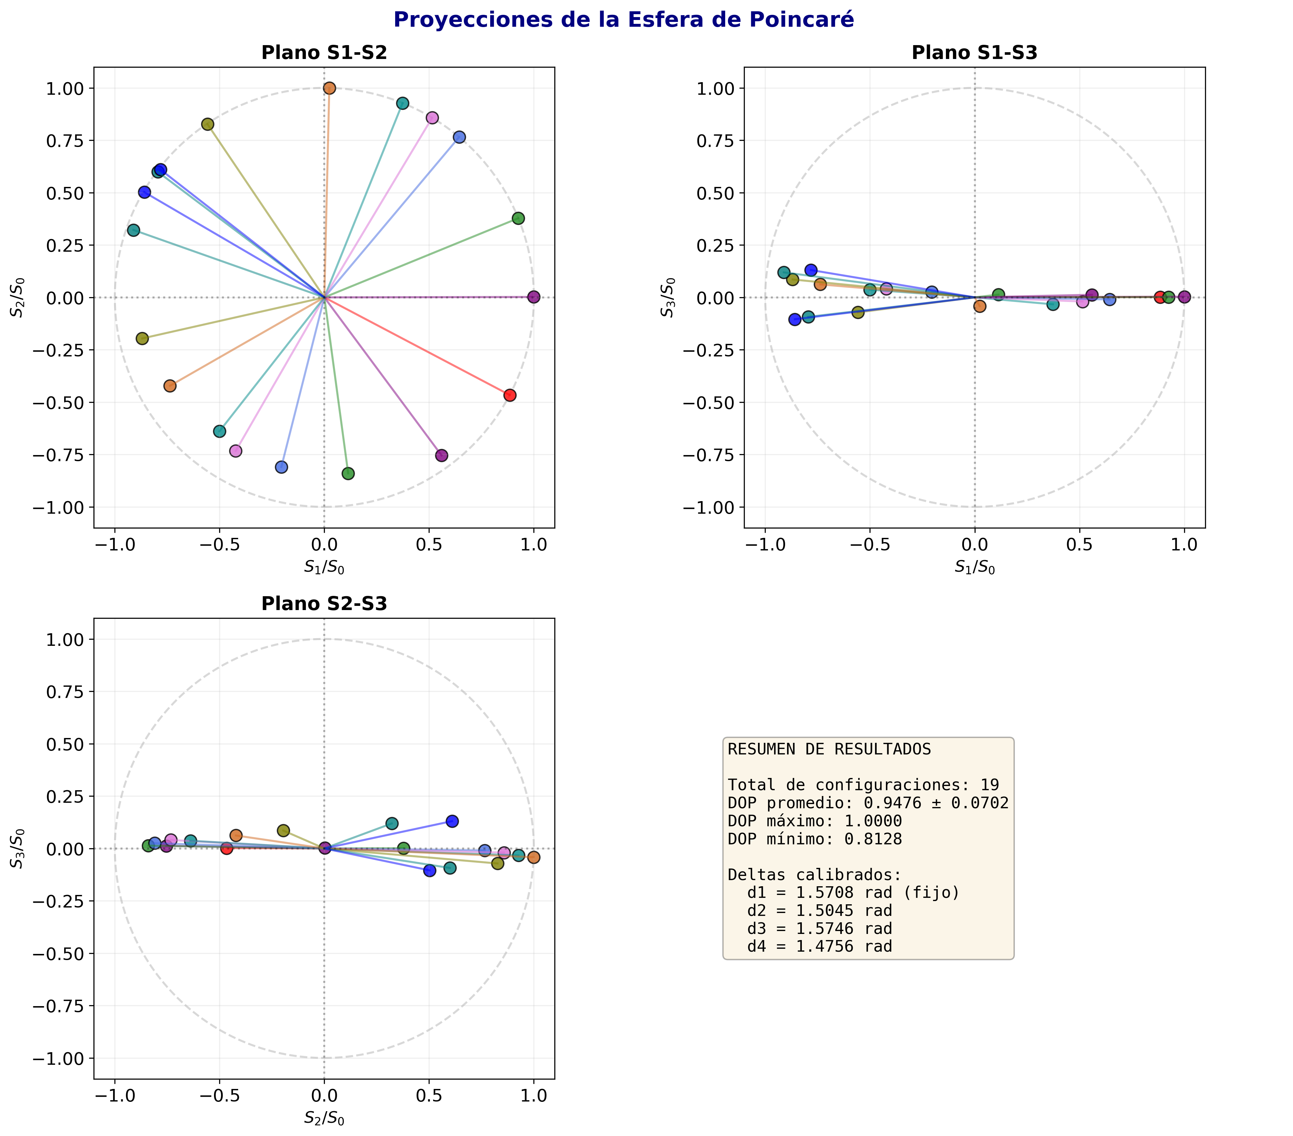
Pico Code/Clases/proyecciones_poincare.png
