BernardoPironio/Polarimetro/Pico Code/Clases/resultados_polarimetria.csv

Configuración | S0 | S0_err | S1 | S1_err | S2 | S2_err | S3 | S3_err | DOP | DOP_err | v1 | v1_err | v2 | v2_err | v3 | v3_err
6° | 0.7304664793191028 | 0.002833601672321992 | 0.7304605130795959 | 0.004570050819637475 | 0.0014002811502104172 | 0.004579731420928478 | 0.002385013840185863 | 0.0022203649924141676 | 1.0 | 0.009727596769855518 | 0.9999918322884406 | 0.009727601937108385 | 0.0019169683891801246 | 0.006269602743194189 | 0.003265055834470365 | 0.0030396797780276696
12° | 0.7039302168777093 | 0.0033035546305315677 | 0.6520972690888485 | 0.005327993938483251 | 0.26511399951262893 | 0.005339280082109789 | 0.0006914533806844191 | 0.0025886126247478465 | 1.0 | 0.01158334568267454 | 0.926366354865733 | 0.011446186641400867 | 0.3766197176313089 | 0.007788167846751221 | 0.000982275464393855 | 0.003677373932551568
18° | 0.6940015177421179 | 0.0033890867923569404 | 0.4480634674132712 | 0.005465940784697099 | 0.5299271970588234 | 0.00547751907697767 | -0.0073101531862886015 | 0.002655634258551405 | 1.0 | 0.011286901481362088 | 0.645623180869996 | 0.010646372024171305 | 0.7635821875186987 | 0.008729182824490193 | -0.010533338904029545 | 0.0038269001358702997
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
