BernardoPironio/Polarimetro/Informe/Figuras/dispositivo_experimental.pdf

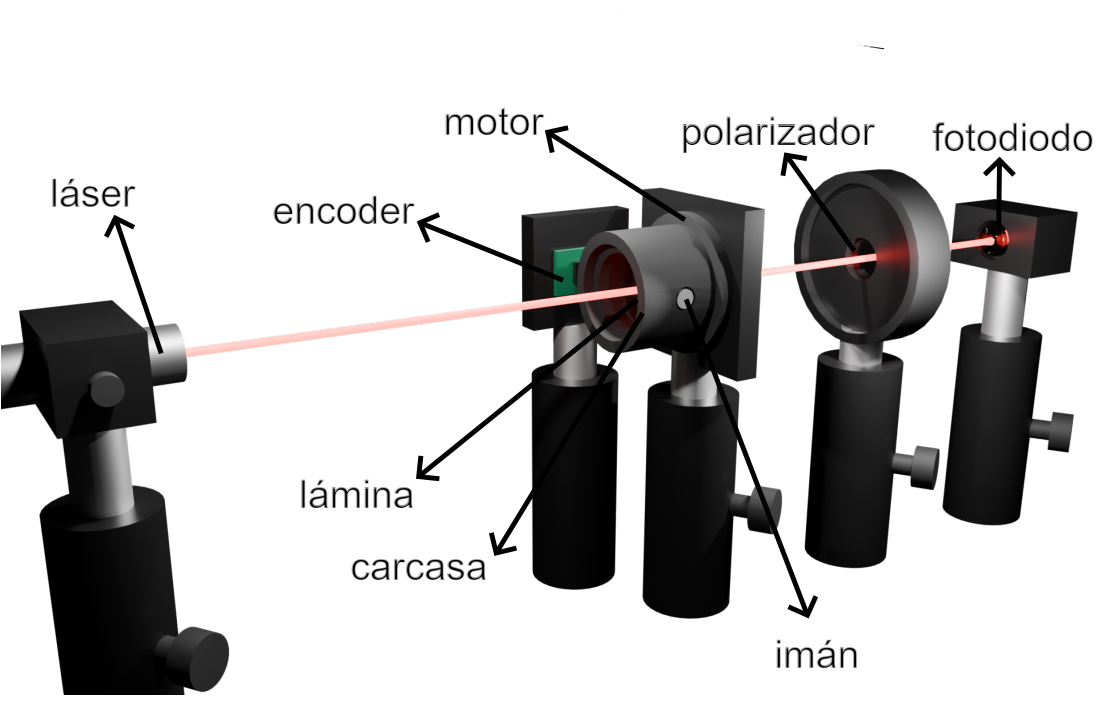
[picture p23: page 1]
láser; encoder; imán; polarizador; fotodiodo otor; carcasa; lámina
