BernardoPironio/Polarimetro/Informe/Figuras/motor_bldc_rotor_externo.pdf

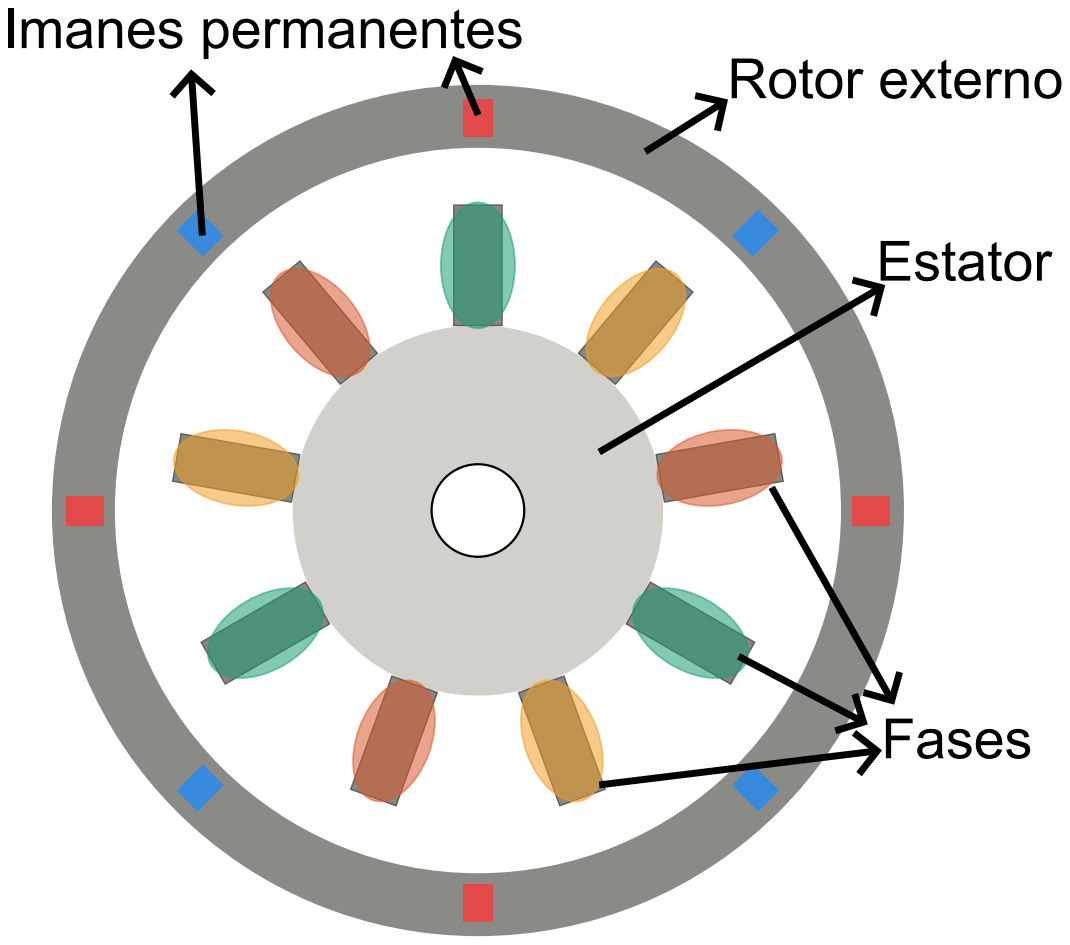
[picture p24: page 1]
Rotor externo; Estator; Fases; Imanes permanentes
