BernardoPironio/Polarimetro/Informe/Figuras/vista_S1S3_45rep.pdf

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

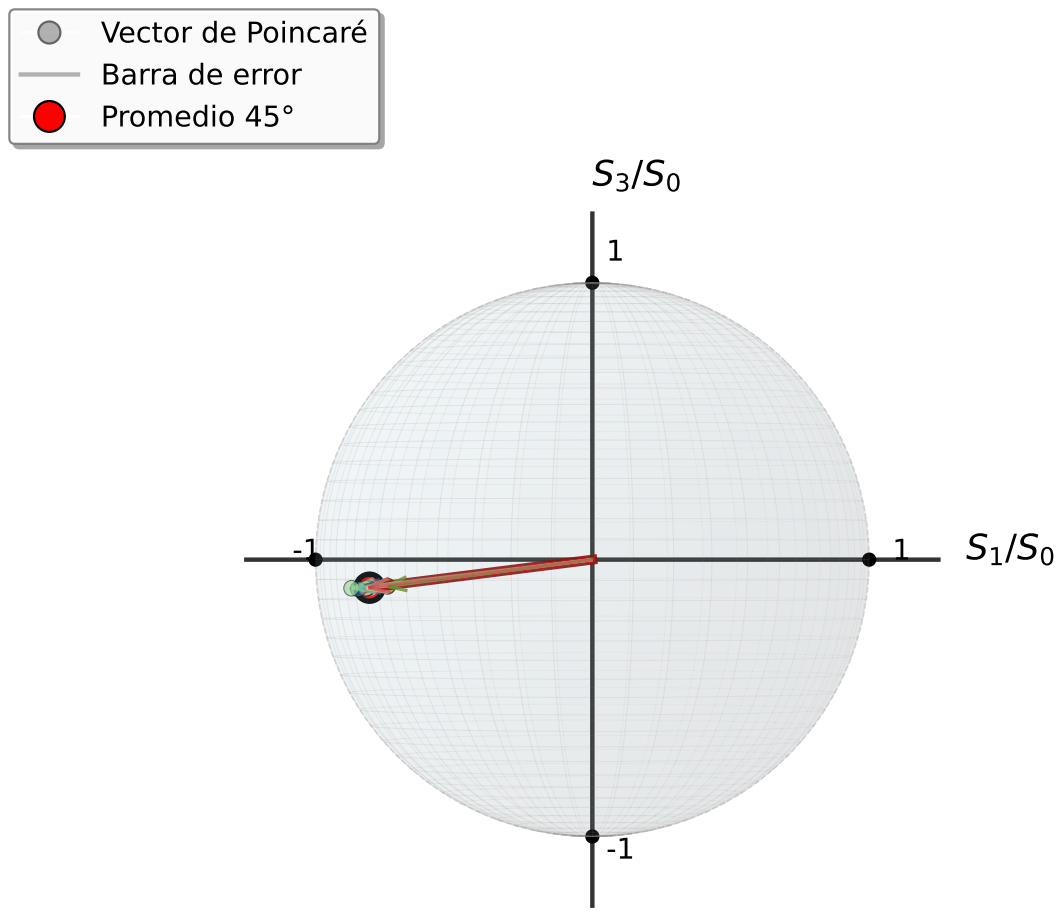
[picture p34: page 1]
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
