BernardoPironio/Polarimetro/Informe/Figuras/vista_S1S3_nueva_rep.pdf

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

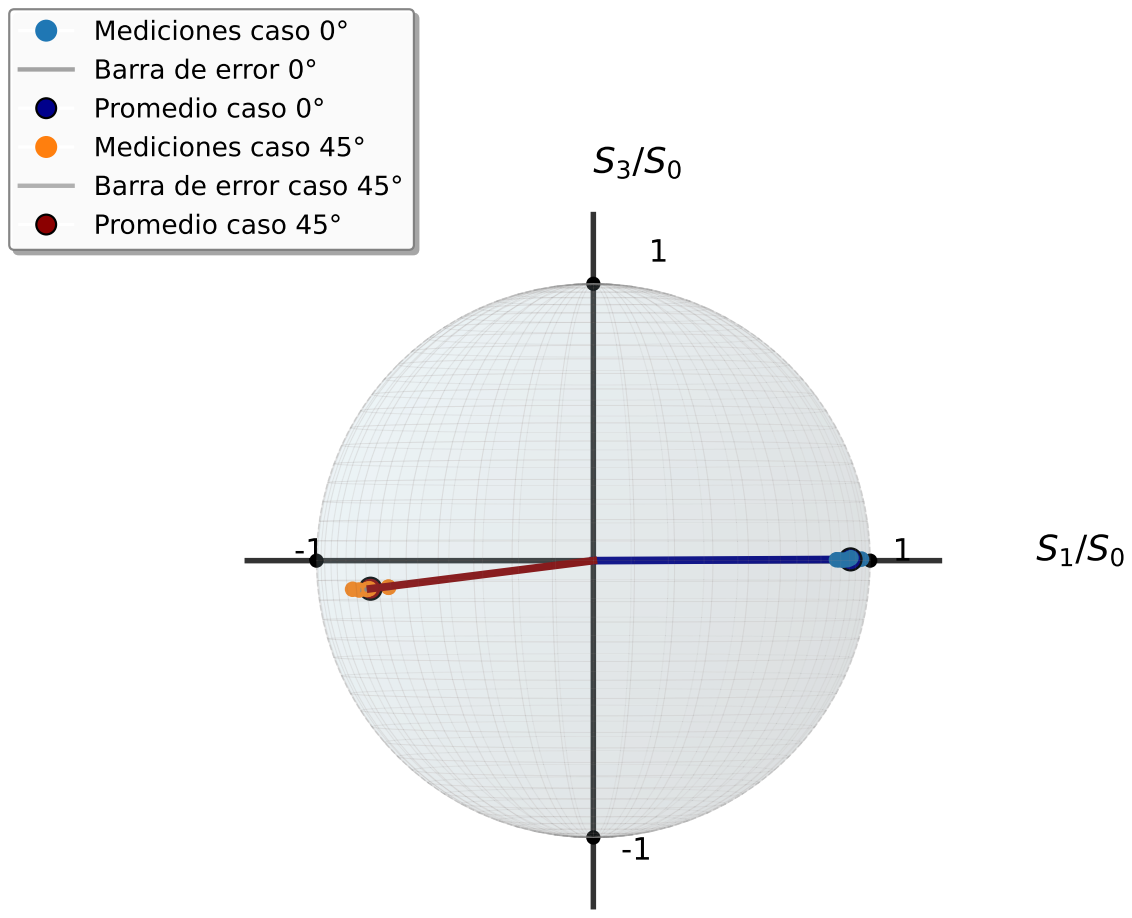
[picture p35: page 1]
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
