BernardoPironio/Polarimetro/Informe/Figuras/0confvista_S1S2.pdf

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

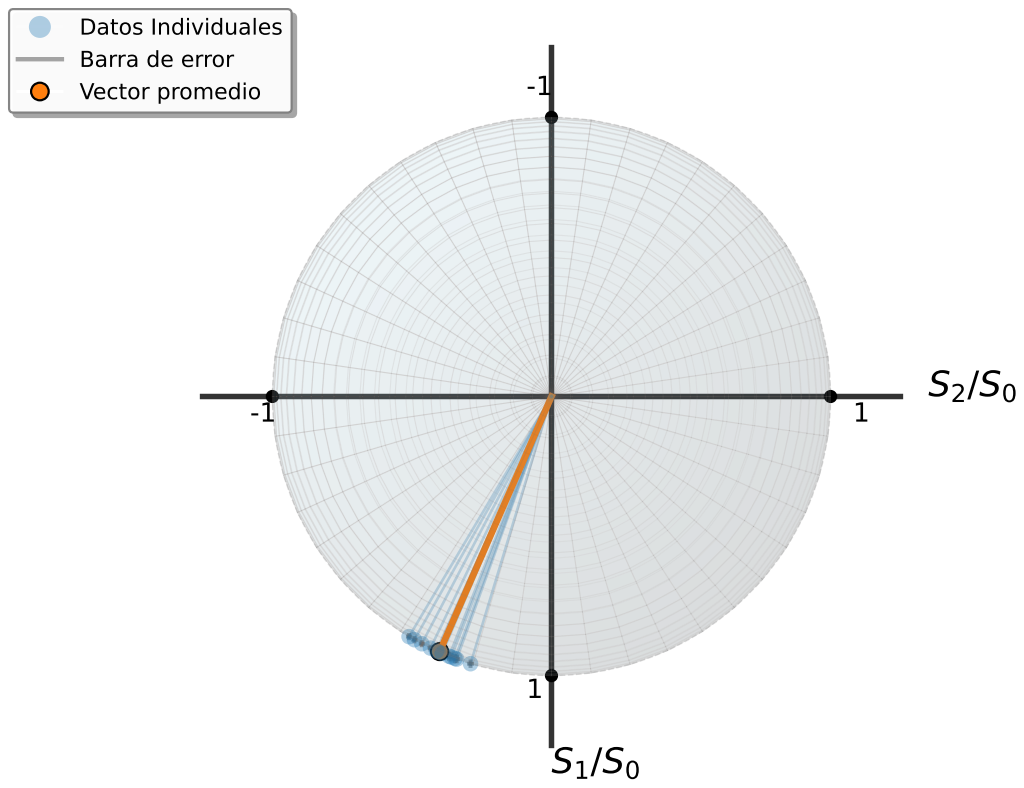
[picture p36: page 1]
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
