BernardoPironio/Polarimetro/Informe/Figuras/esfera_todas_S1S3.pdf

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

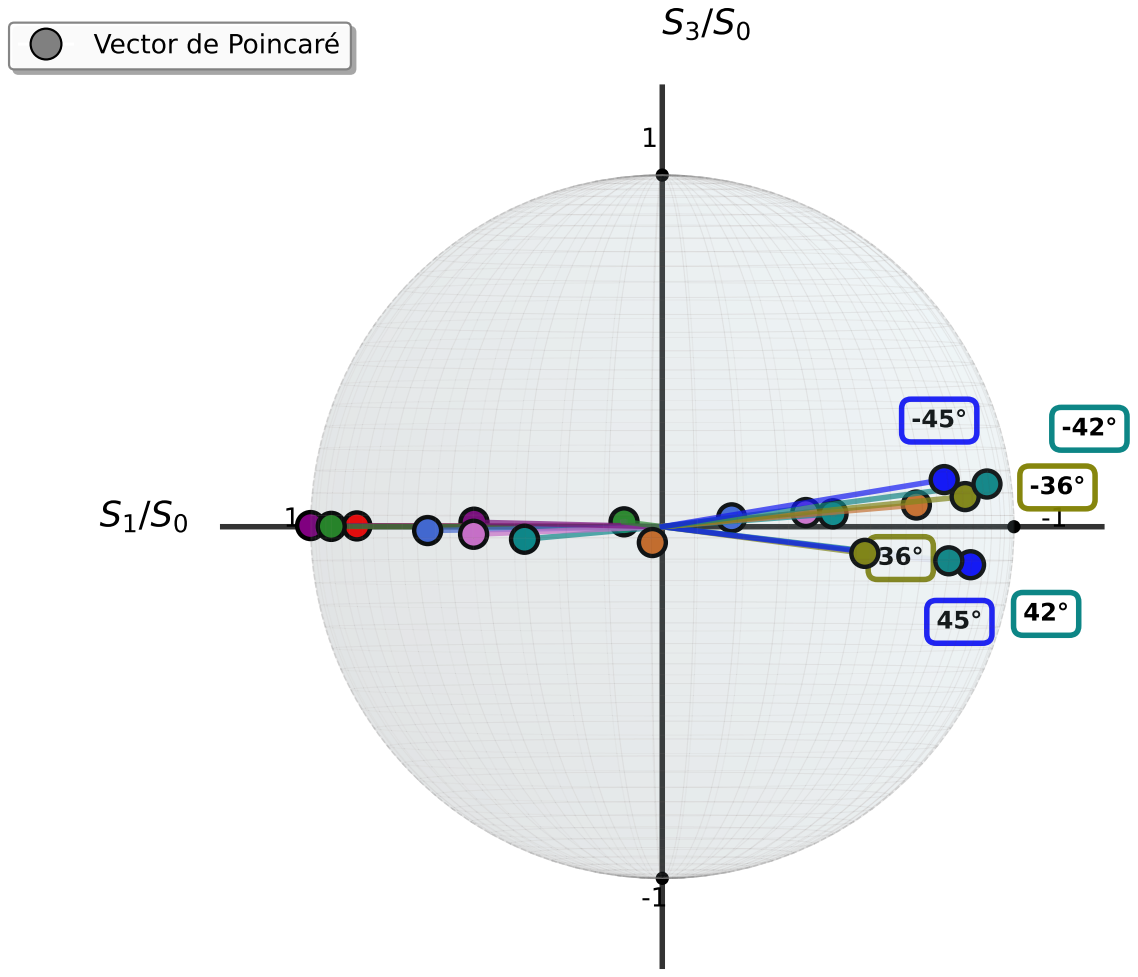
[picture p46: page 1]
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
