BernardoPironio/Polarimetro/Pico Code/Clases/angulos_S1S2_delta.pdf

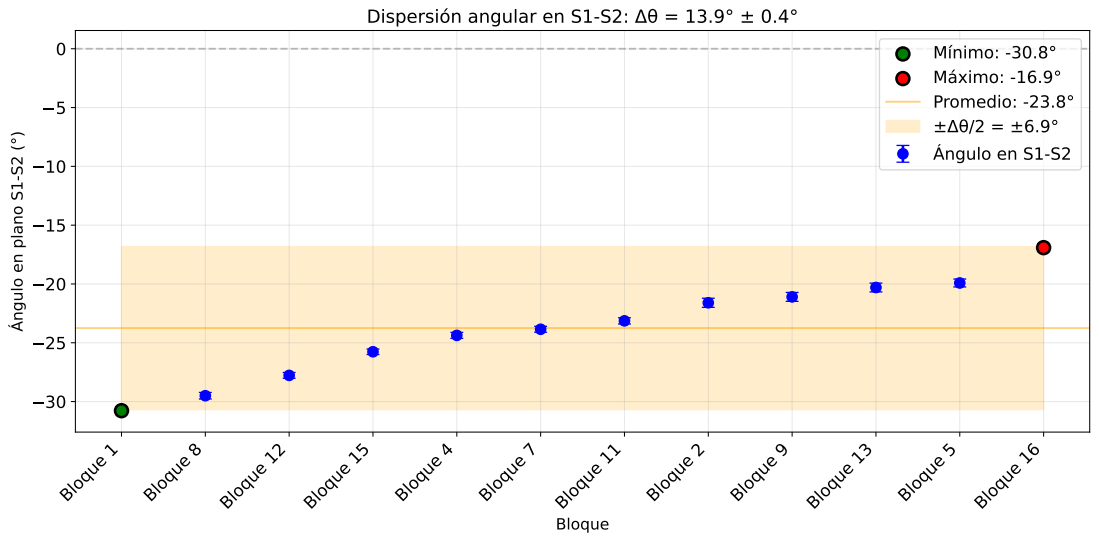
[picture p48: page 1]
Bloque 1; Bloque 8; Bloque 12; Bloque 15; Bloque 4; Bloque 7; Bloque 11; Bloque 2; Bloque 9; Bloque 13; Bloque 5; Bloque 16; Bloque; Dispersión angular en S1-S2:; Ángulo en S1-S2

Mínimo: -30.8°
Máximo: -16.9° Promedio: -23.8°

Ángulo en plano S1-S2 (°)
