BernardoPironio/Polarimetro/Pico Code/Clases/angulos_S1S2_por_bloque.pdf

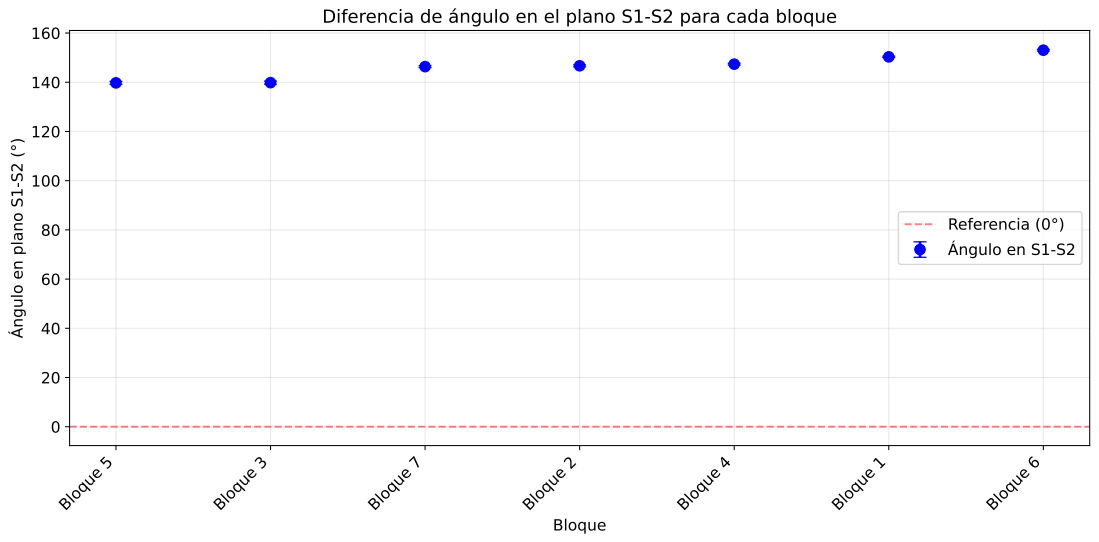
[picture p50: page 1]
Bloque 5; Bloque 3; Bloque 7; Bloque 2; Bloque 4; Bloque 1; Bloque 6; Bloque; Referencia (0°) Ángulo en S1-S2

Diferencia de ángulo en el plano S1-S2 para cada bloque

Ángulo en plano S1-S2 (°)
