BernardoPironio/Polarimetro/Pico Code/sensor__motoriman.py

from machine import Pin, PWM, I2C
from math import sin, pi
import time
import gc  # <-- IMPORTAR EL MÓDULO GC

# -----------------------------
# I2C
# -----------------------------
i2c = I2C(0, sda=Pin(0), scl=Pin(1), freq=10000)
print("Devices found:", i2c.scan())

ADDR = 0x36
STATUS = 0x0B

# -----------------------------
# PINES MOTOR
# -----------------------------
PIN_U = 2
PIN_V = 3
PIN_W = 4
PIN_EN = 5

# -----------------------------
# PARAMETROS
# -----------------------------
PWM_FREQ = 100000
V_SUPPLY = 24.0
V_AMPLITUDE = 6.0
VELOCIDAD = 400.0

# -----------------------------
# PWM
# -----------------------------
pwm_u = PWM(Pin(PIN_U))
pwm_v = PWM(Pin(PIN_V))
pwm_w = PWM(Pin(PIN_W))

pwm_u.freq(PWM_FREQ)
pwm_v.freq(PWM_FREQ)
pwm_w.freq(PWM_FREQ)

en = Pin(PIN_EN, Pin.OUT)
en.value(0)   # arranca apagado

# -----------------------------
# FUNCION AUXILIAR
# -----------------------------
def set_phase_voltage(pwm_obj, voltage, v_supply):
    if voltage < 0:
        voltage = 0
    if voltage > v_supply:
        voltage = v_supply

    duty = int((voltage / v_supply) * 65535)
    pwm_obj.duty_u16(duty)

# -----------------------------
# VARIABLES
# -----------------------------
theta = 0.0
t_prev = time.ticks_us()
count = 0
md_prev = 0   # para detectar flanco

# -----------------------------
# PREPARAR MEMORIA (evita GC durante el movimiento)
# -----------------------------
print("Preparando memoria...")
gc.collect()           # Limpiar memoria ahora
gc.disable()           # <--- DESACTIVAR GARBAGE COLLECTOR
print("GC desactivado - el motor no debería golpear")

# Reservar espacio para variables temporales (opcional)
temp_vars = [0.0] * 10  # Reserva memoria de antemano

# -----------------------------
# MAIN
# -----------------------------
try:
    en.value(1)   # habilitar driver
    print("Motor encendido - girando...")
    t_antes=0
    t_ahora=time.ticks_ms()
    
    while True:
        # leer sensor
        s = i2c.readfrom_mem(ADDR, STATUS, 1)[0]
        md = (s >> 5) & 1

        # detectar flanco ascendente: 0 -> 1
        if md == 1 and md_prev == 0:
            count += 1
            periodo = time.ticks_ms()-t_antes
            t_antes =time.ticks_ms()
            print(periodo)
            
        md_prev = md

        # tiempo transcurrido
        t_now = time.ticks_us()
        dt = time.ticks_diff(t_now, t_prev) / 1_000_000.0
        t_prev = t_now
        
        
        # LIMITAR dt MÁXIMO (evita saltos grandes si hay micro-pausas)
        if dt > 0.01:  # Máximo 10ms
            dt = 0.01

        # avanzar ángulo eléctrico
        theta += VELOCIDAD * dt
        
        # Mantener theta en rango (evita overflow)
        if theta > 2 * pi:
            theta -= 2 * pi

        # tres senoides desfasadas 120°
        ua = V_AMPLITUDE * sin(theta)
        ub = V_AMPLITUDE * sin(theta - 2*pi/3)
        uc = V_AMPLITUDE * sin(theta - 4*pi/3)

        # desplazar al rango 0 ... V_SUPPLY
        ua_pwm = ua + V_SUPPLY / 2
        ub_pwm = ub + V_SUPPLY / 2
        uc_pwm = uc + V_SUPPLY / 2

        # aplicar al driver
        set_phase_voltage(pwm_u, ua_pwm, V_SUPPLY)
        set_phase_voltage(pwm_v, ub_pwm, V_SUPPLY)
        set_phase_voltage(pwm_w, uc_pwm, V_SUPPLY)
        
        # Pequeña pausa para estabilidad (opcional)
        # time.sleep_us(50)  # Descomentar si es necesario

except KeyboardInterrupt:
    print("\nInterrupción por teclado")

finally:
    print("Apagando motor...")
    
    # Reactivar GC antes de apagar (por si acaso)
    gc.enable()
    
    pwm_u.duty_u16(0)
    pwm_v.duty_u16(0)
    pwm_w.duty_u16(0)
    
    en.value(0)
    
    print(f"Pulsos detectados: {count}")
    print("GC reactivado")
