BernardoPironio/Polarimetro/(commit log)

2026-03-25 Agrego archivo inicial para las mediciones
2026-03-25 Agrego print de coefs
2026-03-27 mediciones manuales
    [medicion_manual_v0.1.csv]
2026-03-28 Emprolijo las cosas que probamos, y agrego el test del ajuste por distintas ventanas
2026-03-28 Agregi el test 3 que prueba con el voltaje invertido
2026-03-31 Seguí haciendo ajustes y agregue una representacion de Poincare en analisis
2026-03-31 Agrego carpeta para archivos de la pico, y archivo de prueba
2026-04-04 Acomodo codigo y corrijo celdas de cargado de datos
2026-04-07 Mediciones ortogonal y paralelo
    [medicion_manual_polarimetro_ortogonal.csv, medicion_manual_polarimetro_paralelo.csv]
2026-04-08 Ajustes con errores y puntos en la esfera
2026-04-09 codigos test de salidas I2C y analogica del encoder
2026-04-10 Codigo funcional para el driver
2026-04-14 Agrego codigo pico
2026-04-14 nuevas mediciones de caso ortogonal
    [medicion_manual_polarimetro_ortogonal2.csv]
2026-04-14 analisis de mediciones nuevas
2026-04-14 Agrego codigo de control del motor
2026-04-16 agrego prueba ide arduino iman y motor
2026-04-17 Agrego control de motor+sensor funcional
2026-04-17 iman + motor, con clean garbage
2026-04-21 Agrego codigo de PIO para motor y sensor
2026-04-21 mediciones paralelo axis
    [medicion_manual_polarimetro_paralelo2.csv]
2026-04-24 cambiando forma de normalizar los ajustes
2026-05-08 Agrego codigo de medcion con guardado de archivo y primer archivo
    [datos_motor.csv]
2026-05-08 primera adquisición de datos sistemática y análisis
2026-05-08 Ultimos archivos de adqusisicion
2026-05-18 Agrego archivo para futuro informe
2026-05-19 Corrijo unas coas del latex
    [datos_motor.csv]
2026-05-26 ajuste integrado con calibración de deltas
2026-06-05 Agrego todos los codigos nuevos del nuevo encoder
    [datos.csv, datos_motor.csv]
2026-06-05 ajuste sistema integrado
    [datos 600pts.csv, datos 600ptsx20_reinicio t x vuelt.csv, datos 600ptsx20_tnorm.csv, datos indice indicado (+600x20).csv]
2026-06-09 Ajuste de vueltas de primeras mediciones con sistema integrado
2026-06-09 Codigo para control desde el serial port
    [datos.csv, medicion.csv]
2026-06-11 Ajuste sobre medias de curvas
2026-06-12 nuevos intentos de ajuste
2026-06-12 Codigos de graficos de ajustes y esfera que funcionaron antes de que se rompa todo
2026-07-02 Subo cositas
    [bloque_0000_0001.csv, bloque_0002_0003.csv, bloque_0004_0005.csv, bloque_0006_0007.csv, bloque_0008_0009.csv, bloque_0010_0011.csv, bloque_0012_0013.csv, bloque_0014_0015.csv]
2026-07-02 TODAS LAS MEDICIONES GOD
    [bloque_0000_0002.csv, bloque_0003_0005.csv, bloque_0006_0008.csv, bloque_0009_0011.csv, bloque_0012_0014.csv, bloque_0015_0017.csv, bloque_0018_0020.csv, bloque_0021_0023.csv]
2026-07-06 analisis de adquisicion final de datos
2026-07-07 Mejorando ajuste de doble calibracion + errores
2026-07-08 calibracion doble y calcul de errores
2026-07-08 Agrego codigo del stepper del ide de arduino
2026-07-08 mediciones nuevas
    [bloque_0000_0002.csv, bloque_0003_0005.csv, bloque_0006_0008.csv, bloque_0009_0011.csv, bloque_0012_0014.csv, bloque_0015_0017.csv, bloque_0018_0020.csv, bloque_0021_0023.csv]
2026-07-10 reanalisis de datos
2026-07-10 ajuste final exitoso y agregado de resultados informe
    [resultados_polarimetria.csv]
2026-07-11 Agrego gradico de circuito(a terminar)
2026-07-11 Termino grafico del circuito
2026-07-11 Toco un par de cosas
2026-07-11 Agrego imagen del dispositivo(faltan las labels de cada cosa)
2026-07-12 changes que quedaban commitear
2026-07-12 subido de imagenes, procesado
2026-07-12 Agrego y corrijo un par de cosas
2026-07-12 Agrego un par de cosas
2026-07-13 Arreglo un par de cosas
2026-07-14 edicion de figuras
2026-07-14 Agrego comentario sobre la implementacion de todo el dispositivo experimenttal
2026-07-14 Agrego un poco de texto y cambio algo de las imagenes
2026-07-18 nuevos graficos de repetibilidad
2026-07-18 Corrijo cosas de la intro
2026-07-19 graficos y texto nuevo de mult curvs
2026-07-20 creo imagen de presentacion
2026-07-20 Cambios finales en el informe para entrega
